andykarpov/karabas-pro/software/profi/net-tools/src/netman/readme.md

Исходники netman с поддержкой Karabas Pro доступны из оригинального репозитария nihirash:  https://github.com/nihirash/zx-net-tools/
либо из ветки karabas-pro форка https://github.com/andykarpov/zx-net-tools/

Для сборки используйте опции:

1. make karabaspro - для сборки версии под ZX UNO UART
2. make karabaspro-zifi - для сборки версии под ZIFI UART
