andykarpov/karabas-pro/software/profi/pq-dos/README.md

PQ-DOS boot

# Как создать загрузочную дискету с PQ-DOS

1) Записываем на SD карту образ pqdos1.fdi
2) По menu+F4 переходим в FDImage
3) Выбираем образ, записываем на дискету
4) Menu+F2 для переключения в режим PQ-DOS BIOS
5) вставляем дискету, загружаемся с нее

# Как создать загрузочный HDD из CF карты

## На PC (желательно под Linux)
1) создаем primary partition размером до 1 Гб типа FAT16
2) Устанавливаем флаг bootable на раздел
3) По желанию создаем extended partition и в нем N дополнительных разделов типа FAT16

## Грузимся с дискеты
4) Копируем с дискеты файлы TRDBOOT.BIN, QDOS.SYS, IO.DRV, CMD.COM, CONFIG.SYS и AUTOEXEC.BAT в корень диска C
Важно: файлы TRDBOOT.BIN, QDOS.SYS и IO.DRV должны быть нефрагментированы.
Можно утилитой sys это сделать, но она пока не проверяет файлы на фрагментированность
5) Создаем директорию DOS, копируем с дискеты все что касается DOS'а в эту диреторию
6) Создаем директорию DN, копируем все что касается DN в эту директорию
7) запускаем FIXBOOT C:
8) запускаем FIXMBR /PM

## Перезагружаемся без дискеты
9) профит! :)

ЗЫ: готовый образ 1ГБ CF-карточки можно скачать тут: 
https://drive.google.com/file/d/1a-WIUXuHLKoJI3obKjNGY0Axmqy46rGw/view?usp=sharing
