andykarpov/karabas-pro/software/profi/net-tools/release/README.md

Сетевые утилиты для Karabas PRO
===============================

На данный момент они работают только с SD-картой, и им критично расположение в каталоге Wifi(т.е. необходимо скопировать zinetman.$c, ziugophy.$c и player.bin в каталог wifi, находящийся в корне SD-карты).

У утилит нет зависимости от CP/M или PQ-DOS - используется загружаемый FatFS. 

Запускаются утилиты сразу из fatall'а.

Для настройки ESP и подключения к точке доступа используется netman - он проведет инициализацию чипа, получит список сетей и предложит вам выбрать нужную. 

Если там пролетит сообщение ERROR - это нормально. 

После настройки уже можно запускать ugophy и пользоваться им. Как только на экране появится приветственная страница - это означает, что вы уже онлайн(она грузится по сети).

Возможность скачивания файлов присутствует - пользуйтесь ей на здоровье.
