andykarpov/karabas-pro/DONATIONS.md

## Donations

### The Author

I will be happy to receive any amount of EUR/USD/UAH. 



### ROMain, FDImage tool, FlashTool, testROM by Doctor Max

Thanks to all bakers, with your help it was possible to release a nice new tool - **FDImage by Doctor Max!**, as well as **FlashTool** and the **ROMain**.

With the FDImage tool you're able to extract FDD images (FDI, PRO, TRD, SCL, TD0) to real floppy disks.

The FlashTool is a useful thing to help users upgrade their FPGA and ROM without touching a programmer.

The ROMain is a main ROM that you see on the screen after powering on the board. There are a few tests, including a test for extended karabas palette.

Feel free to send any amount of RUB/USD/EUR/etc to support **Doctor Max** - a developer of this nice tool:

QIWI: https://qiwi.com/n/DEXIUS

Webmonet WMID: 305965057957

Debt Card: 4817 7601 6316 7095

### Wi-Fi support and gopher browser by nihirash

It would be great to buy some coffee for **nihirash** - author of great tools to support internet on karabas-pro: https://nihirash.net.

Feel free to send any amount of USD/EUR/etc to support **nihirash**:



Thanks in advance to all bakers! :)

Your support matters!
