andykarpov/karabas-pro/docs/photos/karabas-pro-revB-bot.png

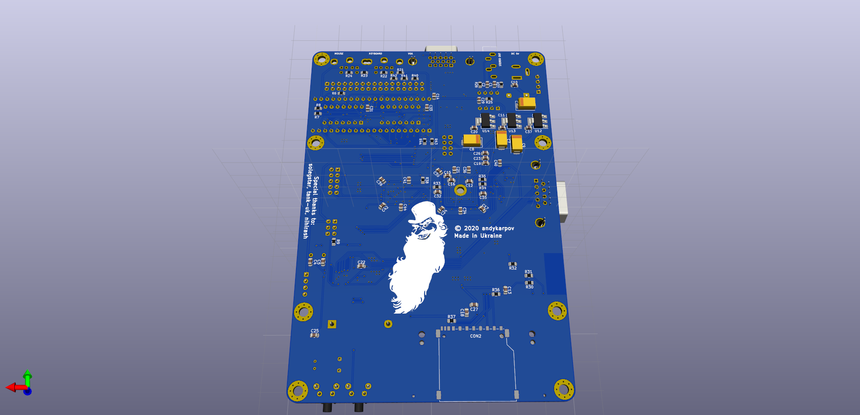
docs/photos/karabas-pro-revB-bot.png
