andykarpov/karabas-pro/docs/photos/karabas-pro-revB-top.png

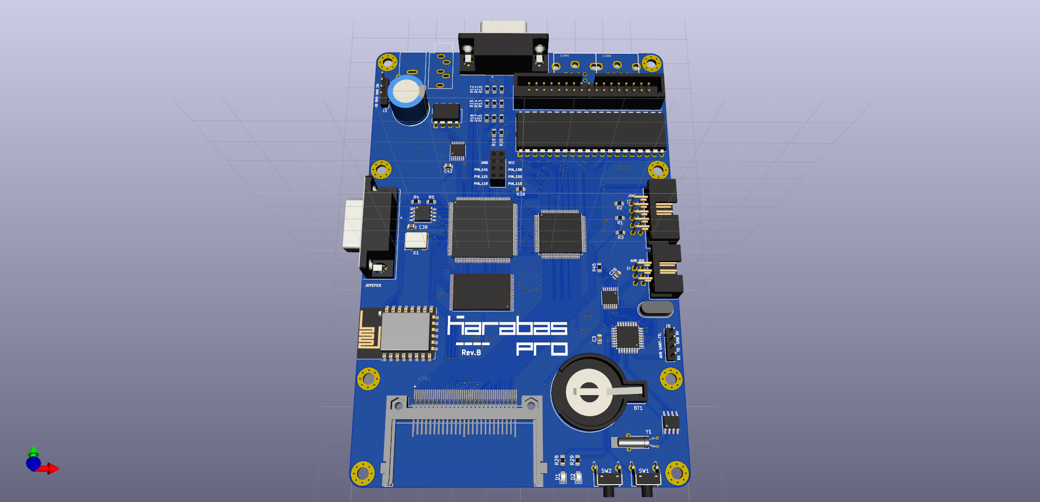
docs/photos/karabas-pro-revB-top.png
