andykarpov/karabas-pro/docs/photos/karabas-pro-revC-back.png

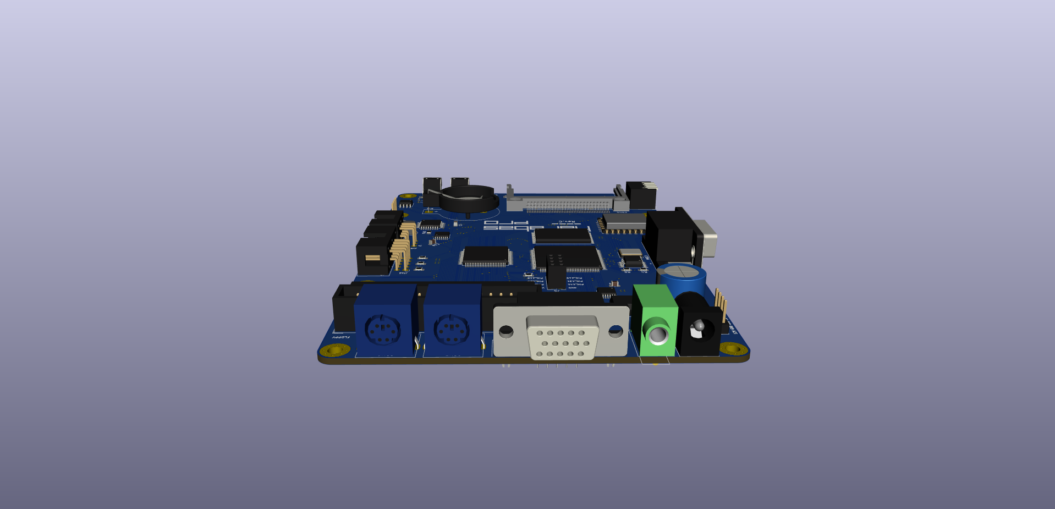
docs/photos/karabas-pro-revC-back.png
