andykarpov/karabas-pro/docs/photos/karabas-pro-revD-bot.png

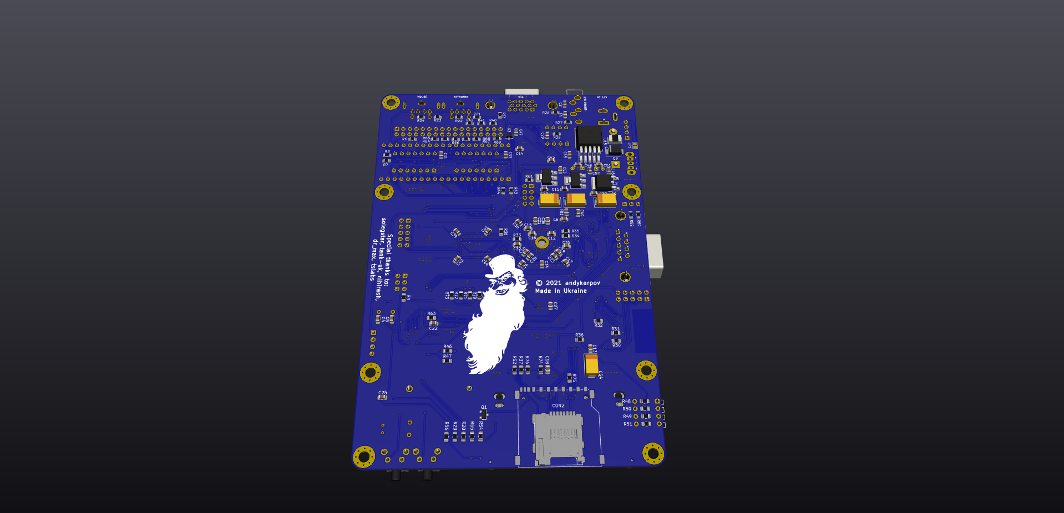
docs/photos/karabas-pro-revD-bot.png
