andykarpov/karabas-pro/docs/photos/karabas-pro-tapeMod_revA-bottom-3d.png

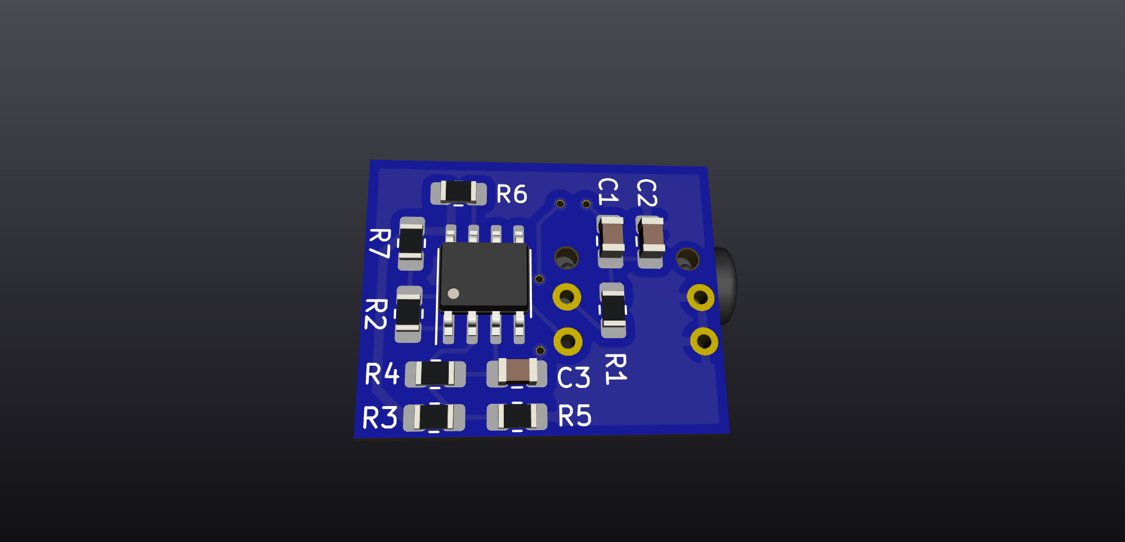
docs/photos/karabas-pro-tapeMod_revA-bottom-3d.png
