andykarpov/karabas-pro/docs/photos/karabas-pro-tapeMod_revA-top-3d.png

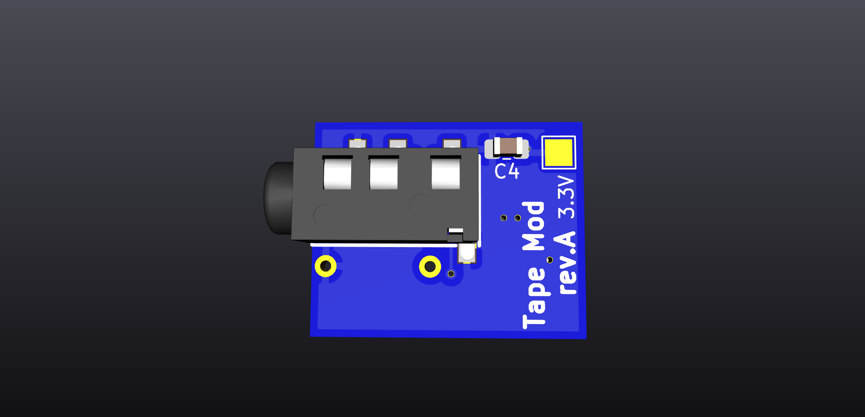
docs/photos/karabas-pro-tapeMod_revA-top-3d.png
