andykarpov/karabas-pro/cases/revC/Karabas_case_FDD_bottom_v1.stl

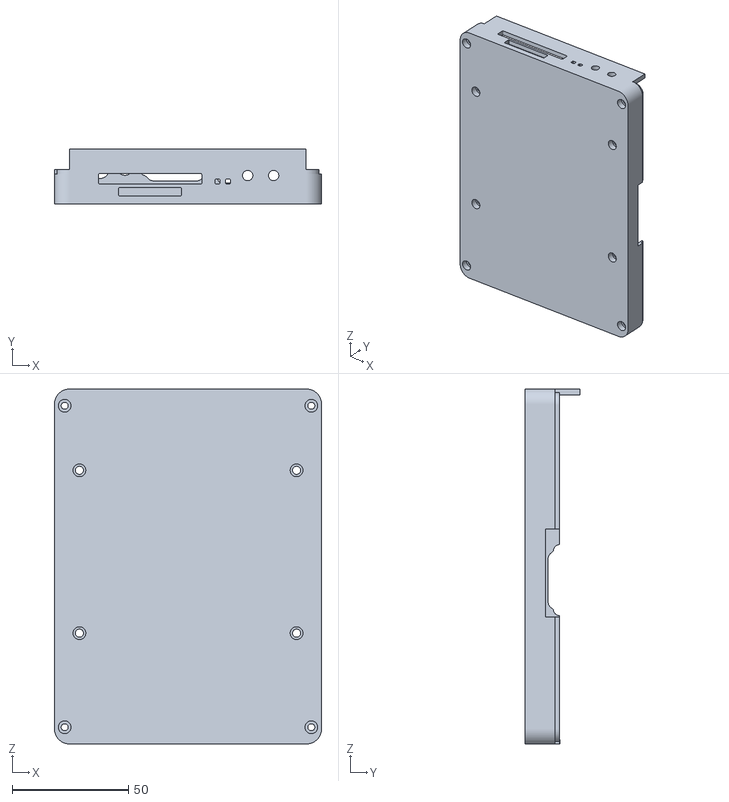
[picture p26: CAD file, 2021-06-01]
cases/revC/Karabas_case_FDD_bottom_v1.stl
115.0 x 23.5 x 152.8
