andykarpov/karabas-pro/cases/revC/Karabas_case_FDD_Logo_top_v1.stl

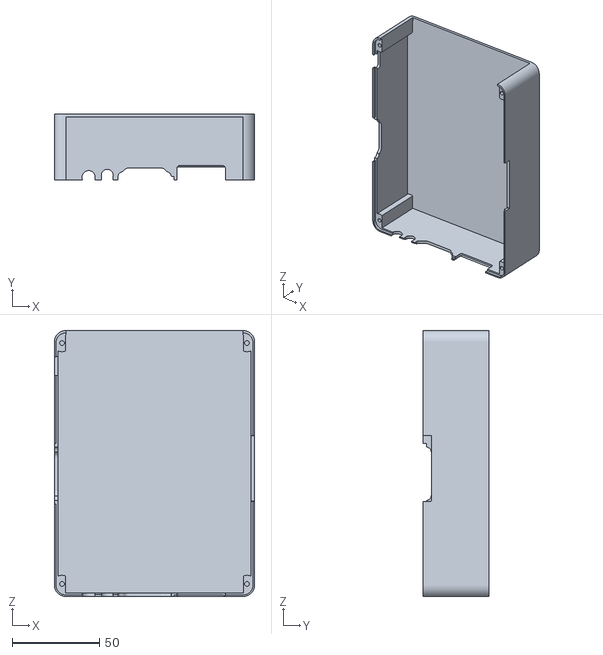
[picture p27: CAD file, 2021-06-01]
cases/revC/Karabas_case_FDD_Logo_top_v1.stl
115.0 x 38.0 x 152.8
