andykarpov/karabas-pro/cases/revDS/KarabasDS_FDD_Logo_case_top_v1.0.stl

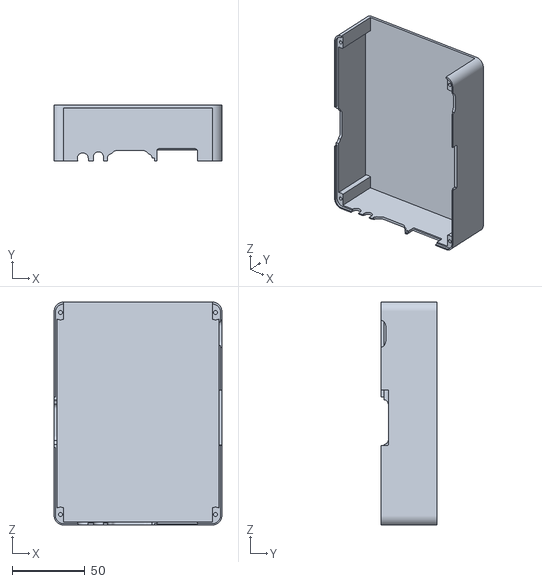
[picture p28: CAD file, 2021-06-01]
cases/revDS/KarabasDS_FDD_Logo_case_top_v1.0.stl
115.0 x 38.1 x 152.8
