andykarpov/karabas-pro/cases/revC/Karabas_case_top_v1.2.stl

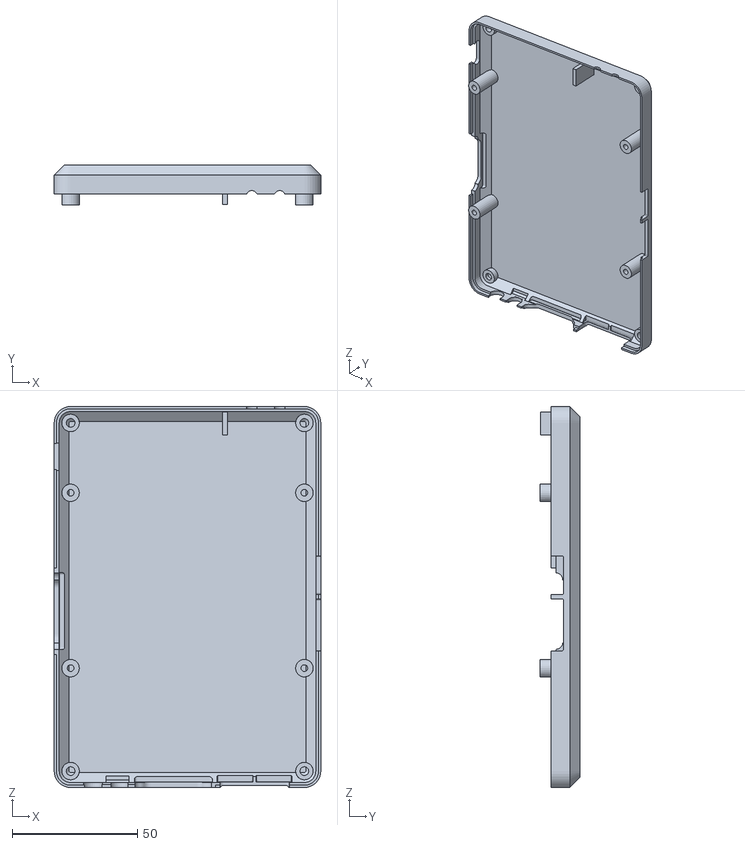
[picture p29: CAD file, 2021-06-01]
cases/revC/Karabas_case_top_v1.2.stl
106.6 x 15.8 x 152.3
