andykarpov/karabas-pro/cases/revC/Karabas_case_bottom_v1.2.stl

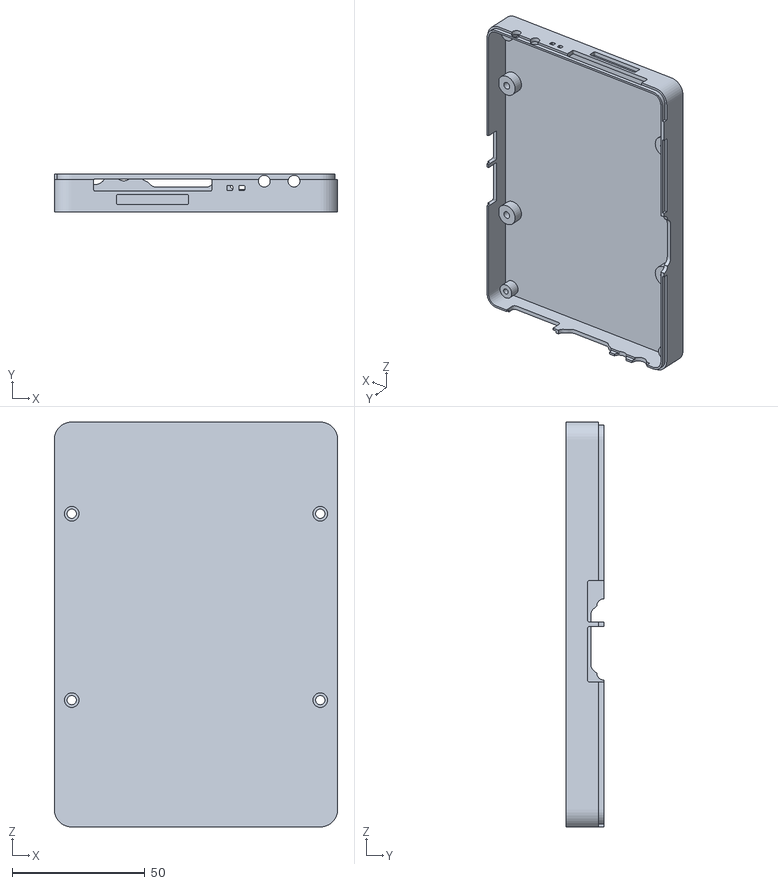
[picture p30: CAD file, 2021-06-01]
cases/revC/Karabas_case_bottom_v1.2.stl
106.6 x 14.4 x 152.3
