andykarpov/karabas-pro/(list of files, cad)

Other CAD files:
cases/revDS/KarabasDS_FDD_case_bottom_v1.N.stl
cases/revDS/KarabasDS_FDD_case_bottom_v1.0.stl
cases/revC/Karabas_case_FDD_top_v1.stl
cases/revC/Karabas_case_FDD_bottom_Support_v1.stl
