andykarpov/karabas-pro/docs/How to write FDI-image on real zx_spectrum_ru.docx

Методика подходит для записи FDI-образов на реальном ZX-Spectrum, оборудованным одним из таких устройств как - Z-Controller, NeoGS или NemoIDE. На примере компьютера Karabas-Pro.

1. Скачать утилиту Wild Disk Copier со всеми плагинами по ссылке на SD-CARD.

https://github.com/andykarpov/karabas-pro/tree/master/software/profi/tools

2. В Сервисном меню Профи выбрать пункт Fatall 0.26.

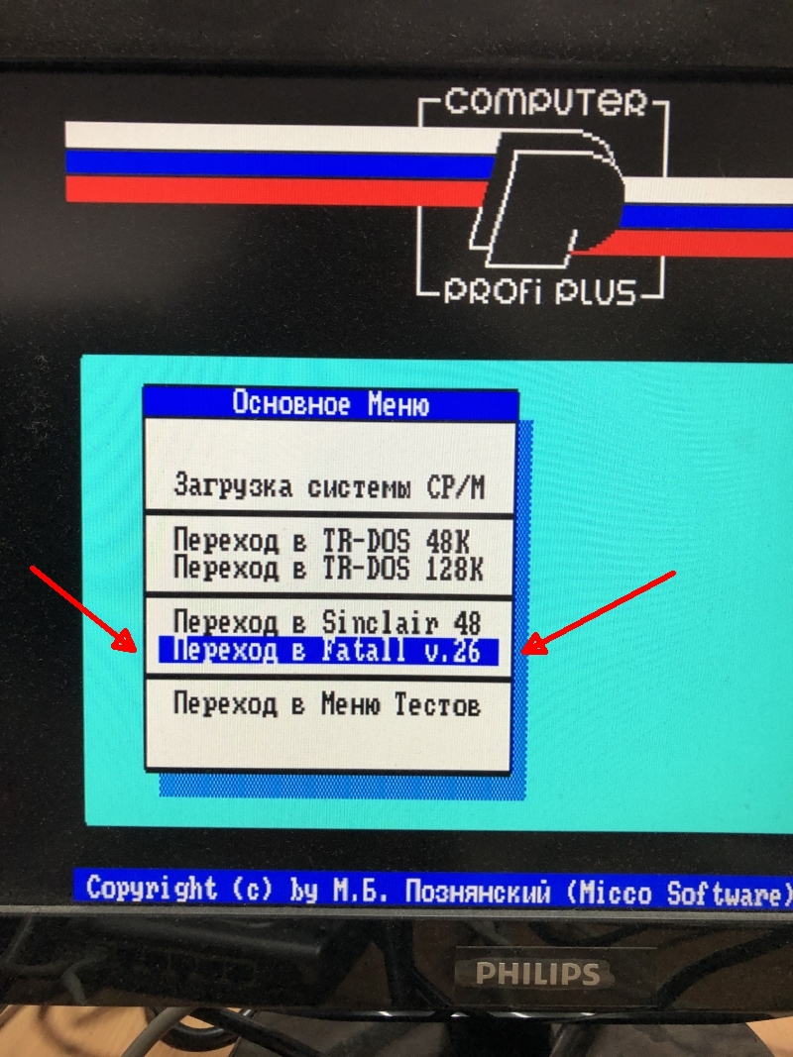
[picture p40: figure]

3. Запустить файл WDC1_26.$C, нажав на нем клавишу Enter.

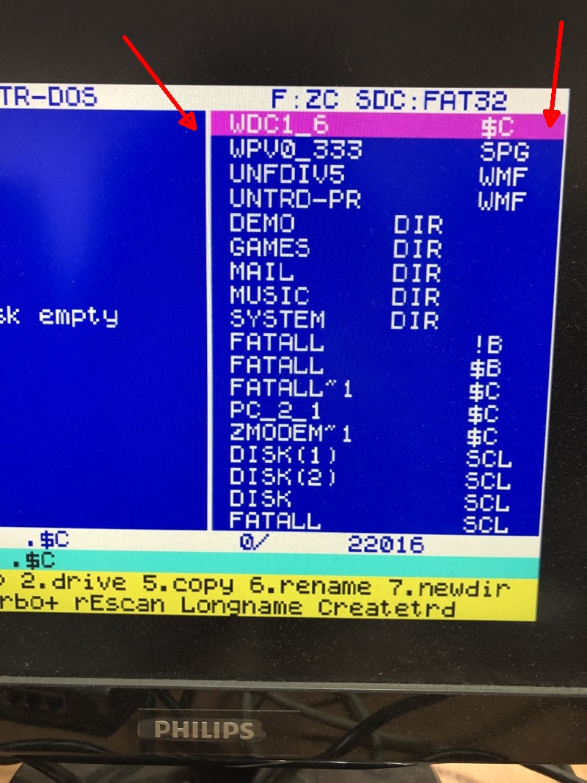
[picture p41: figure]

4. В появившемся меню «Select Driver:» нажать клавишу «3», выбрав драйвер с поддержкой SD-CARD по стандарту ZC (или устройства, которое есть в наличии).

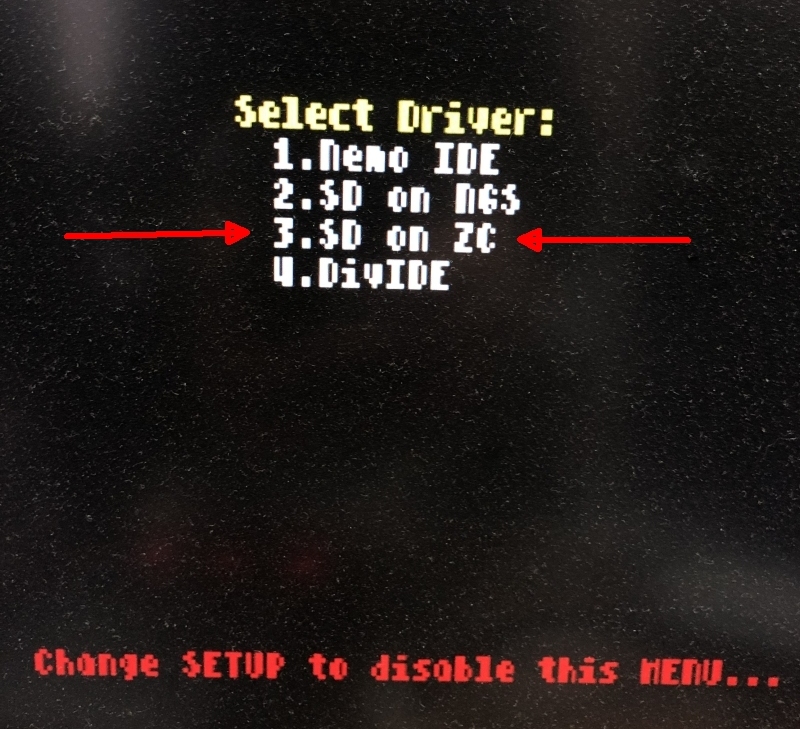
[picture p42: figure]

5. Выделить файл UNFDIV5.WMF и нажать на нем Enter.

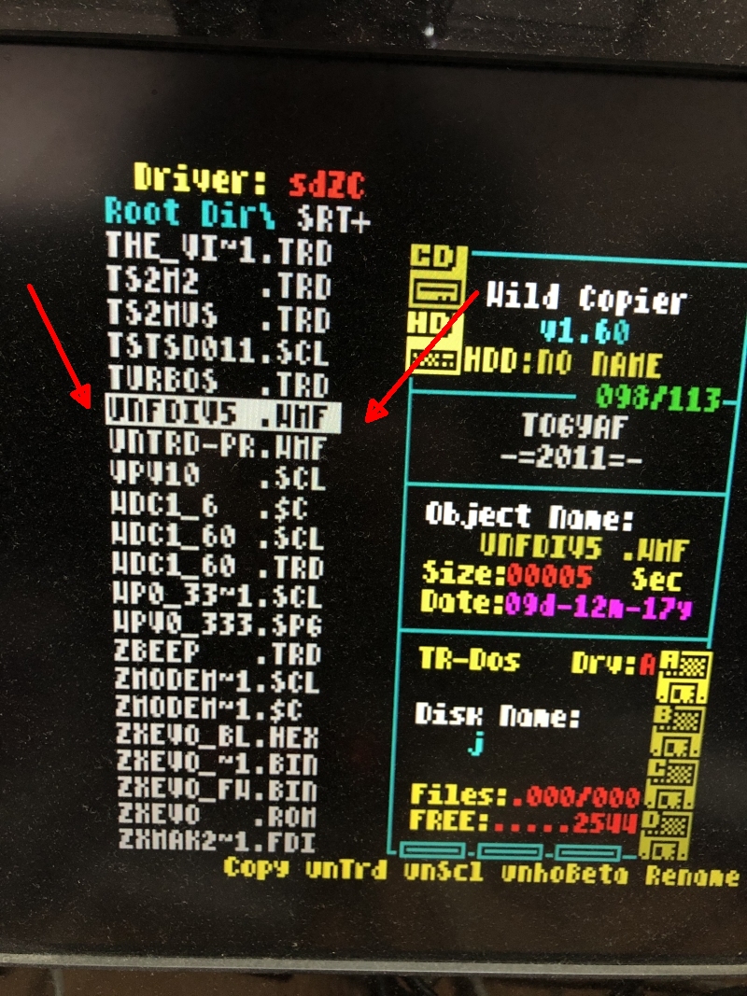
[picture p43: figure]

6. Клавишами 1-4 выбрать дисковод, на который будет записываться образ.
7. Выделить файл с образом *.FDI и нажать клавишу «F».

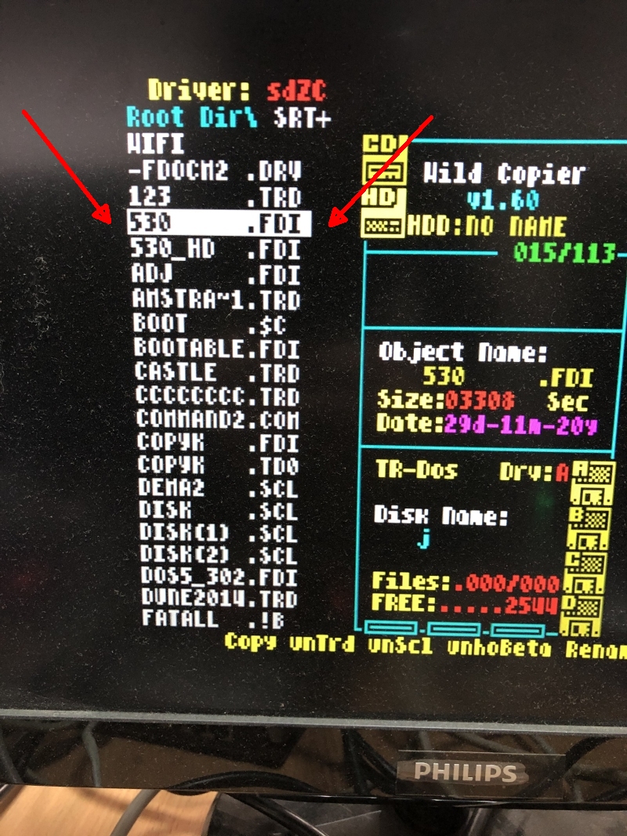
[picture p44: figure]

8. На запрос «Formatting Y/N» нажать клавишу «Y».

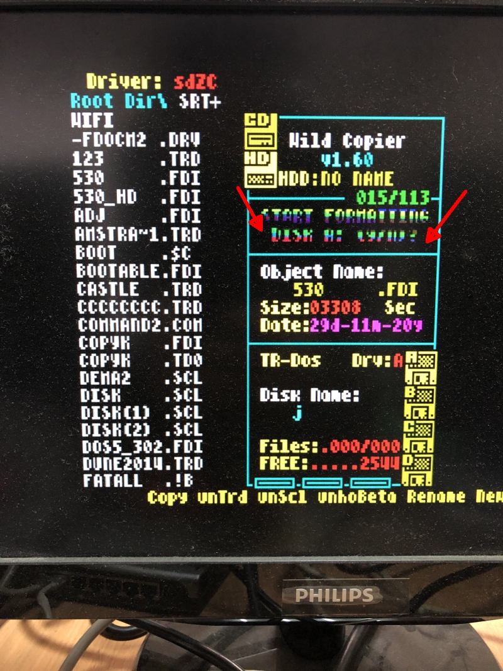
[picture p45: figure]

9. Дождаться записи образа на дискету.
