andykarpov/karabas-pro/ERRATA-REVB.md

# ERRATA rev.B

1) Missing 10k pull-up on the /AVR_CS line. Without that pull-up you'll be unable to flash AVR properly on-board.
2) Missing 10k pupp-ups on the BTN1, BTN1 lines.
