andykarpov/karabas-pro/(threads)

Thread 3 (2020-07-29):

PCB: добавить возможность установки ВГ93

andykarpov, 2020-07-29:
1) добавить преобразователь 12В-5В
2) добавить диоды
3) завести 12в на разъем для дисковода

andykarpov, 2020-08-13:
Преобразователь решил не делать, завел 12В с разъема через диоды

Closed 2020-08-13.

Thread 6 (2020-07-31):

PCB: подтяжки

andykarpov, 2020-07-31:
Добавить подтяжки на:
- /AVR_CS, иначе мегу можно запороть, прошивая прямо на плате
- BTN1, BTN2 - у меги эти два входа - чисто аналоговые, там цифповой части нет, соотв и возможности включить встроенные pull-up

andykarpov, 2020-08-13:
Done

Closed 2020-08-13.

Thread 7 (2020-08-14):

Add +5V supply voltage to pin 9 of the VGA connector through footprint 0805.

solegstar, 2020-08-14:
Add + 5V supply voltage to pin 9 of the VGA connector through footprint 0805.

Several purposes are possible:
1. For normal use of the VGA connector - do not solder anything.
2. When using a VGA-HDMI converter, or if you need power at the VGA connector, solder a 0 Ohm resistor.
3. When using the VGA-SCART cable, you can solder a 150-200 ohm resistor and use it to switch the TV to the RGB mode.

andykarpov, 2020-08-14:
Done

Closed 2020-08-14.

Thread 10 (2020-09-29):

AtMega&FPGA: Управление турборежимом

solegstar, 2020-09-29:
Добавить горячую клавишу для управления турборежимом. предложение - win menu + F11. Бит с фиксацией состояния и возможно с запоминанием состояния во внутренней памяти меги.

andykarpov, 2020-10-06:
готово в ветке turbo

Closed 2020-10-06.

Thread 13 (2020-09-29):

FPGA&CPLD:Турборежим

solegstar, 2020-09-29:
Добавить режим повышенного быстродействия Профи.

andykarpov, 2020-09-29:
Тут надо думать, как подружить турбо-режим, память и самое главное - проброс zx bus в CPLD

andykarpov, 2020-10-06:
У нас шина для проброса сигналов ZX BUS имеет разрядность 8 бит.
И пробрасывается из FPGA в CPLD она за 4 такта клока 28 МГц.
Соответственно, в турбо режиме нужно будет умножить тактовую проброса на 2.
То есть, вероятно, весь дизайн перевести на 56 МГц :)

Closed 2020-10-13.

Thread 14 (2020-09-29):

FPGA: UART

andykarpov, 2020-09-29:
Реализовать порты по Кондратьеву на стороне FPGA, сделать вывод RX,TX,CTS,RTS на свободные пины FPGA.

andykarpov, 2021-08-09:
Сейчас для циклона 10к сделан второй UART на uBUS по стандарту ZX-UNO.

Closed 2021-08-09.

Thread 15 (2020-09-30):

FPGA: Serial Mouse

andykarpov, 2020-09-30:
Сделать эмуляцию протокола **Serial мыши** по стандартным портам профика **#F3, #D3, #B3** и тп (ВВ51, ВИ53) в виде отдельного модуля, в который приходят DX,DY,состояние кнопок из AVR (такие же, как используются для кемпстон-мыши).

Материалы для изучения:

- https://www.systutorials.com/docs/linux/man/4-mouse/
- http://www.cpcwiki.eu/index.php/Serial_RS232_Mouse
- https://everything2.com/title/Mouse+protocol
- https://raspberrypi.stackexchange.com/questions/81465/usb-to-serial-rs232-mouse-converter
- http://ww1.microchip.com/downloads/en/appnotes/00519c.pdf

Closed 2020-10-04.

Thread 33 (2020-10-27):

Попробовать UsbHost внутри FPGA

andykarpov, 2020-10-27:
Разобраться в проекте https://github.com/andykarpov/UsbHost/, https://marsohod.org/projects/proekty-dlya-platy-marsokhod3/404-two-usbhost-ports-keyb-mouse, https://marsohod.org/projects/proekty-dlya-platy-marsokhod3/399-usb-host-ctrl,
попробовать реализовать вместо PS/2 + AVR или рядом, для начала - на debug header'е.

Closed 2021-08-09.

Thread 42 (2021-02-18):

AVR: Зависания клавиатуры

andykarpov, 2021-02-18:
Отдебажить и выявить место, где именно в основном цикле происходят залипания логики

andykarpov, 2021-02-20:
в последней прошивке убрал опрос мыши, заменил библиотеку Wire на SWire с неблокирующим ожиданием. вроде проблема ушла.

Closed 2021-02-20.

Thread 43 (2021-03-03):

Добавить моно режим AY

nihirash, 2021-03-03:
Помимо ABC/ACB ввести еще режим Mono ради страдальцев вроде меня :-)

andykarpov, 2021-03-03:
Хех, беда в том, что я уже пробовал его добавить :)))

Переделок возникло - просто масса:

1) 64-байтную посылку между AVR и FPGA нужно добавить еще один байт для передачи нового состояния (хотя там у @solegstar тоже была хотелка для ремапа буквы дисковода по хоткею - так что придется заводить :)

2) чтобы смикшировать программно 2 16-битных сигнала (сложить их, фактически) нужно делать запас на 1 бит от переполнения, то есть результирующий вектор получится 17-битным. и что потом делать - пока не придумал, наверно отрезать младший бит :)

3) При добавлении новой комбинаторной логики в FPGA проект перестает собираться в работоспособном состоянии. Тут, конечно, связано в роутинге внутри FPGA и в отсутствии constraint'ов по клокам, распространению сигналов и тп :) Я даже отдельную ветку завел с игрищами в этом направлении.

В общем попробую в отдельной ветке, вдруг получится :)

andykarpov, 2021-03-08:
Моно режим добавлен в ветке timequest_constraints.
Переключается по Menu+F7 (по кругу - ABC, ACB, MONO).

andykarpov, 2021-03-08:
TO BE TESTED :)

Thread 48 (2021-04-03):

Сделать поддержку геймпада от Sega

andykarpov, 2021-04-03:
Решили делать на стороне FPGA:
0) нужны доработки платы: подать питание +5В на DB9 разъем, а также сигнал select со светодида LED2 (ACT)
1) по хоткею Menu+J будет переключаться режим опроса - механический / sega и отображаться в OSD
2) на стороне меги механический джой будет отдавать 2 старших бита как 0, а sega джой - доп кнопки A, Menu
3) на стороне FPGA будет расширен прием всех 8 бит для порта джоя

Closed 2021-04-05.

Thread 54 (2021-06-02):

Karabas-pro BIOS

andykarpov, 2021-06-02:
Подумать над ТЗ, что должно входить в концепцию BIOS'а для karabas-pro, разработать прототипы экранов и ТЗ для MVP версии. Продумать, как ПЗУ с BIOS будет стартовать, откуда и как переключаться на выбранную прошивку и конфиг и тп.

nihirash, 2021-06-02:
Желательно описать еще как сохранять настройки, чтобы после выключения не начинать с чистого листа 😸

Часы, как я понимаю, не то, чтобы свободны

andykarpov, 2021-08-09:
Пока потребность BIOS'а частично закрыли новым OSD.
Как будут сформированы новые идеи - переоткроем.

Closed 2021-08-09.

Thread 55 (2021-06-21):

Не работает PS/2 клавиатура Perixx PERIBOARD-505

zapolnov, 2021-06-21:
Отладка по UART показала, что клавиатура при подключении посылает постоянно сканкод 0xAA, других сканкодов не посылает.

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

С Эволюшеном и ZXDOS+ клавиатура работает.

По результатам обсуждения в чате Карабаса есть мнение, что клавиатура посылает 0xAA с неправильной четностью, ожидая от компьютера ответ 0xFE, чтобы убедиться, что компьютер включен (https://forum.arduino.cc/t/ps2keyboard-library-teensy-and-usb-keyboard-with-ps2-adapter/57549/7).

andykarpov, 2021-06-21:
В проекте используется вот такая простенькая либа для PS/2 клавы: https://github.com/techpaul/PS2KeyRaw
Контроль четности в ней есть, и по-идее на неправильную четность должно ответить как раз 0xFE.
Что еще может не нравиться клавиатуре - сложно сказать.

Попробую переписать код на базе PS2KeyAdvanced от того же автора, код занимает больше места, но и руки больше развязны будут :) С клавой можно будет общаться, посылать состояния светодиодов и другие команды.
Возможно, в ней этого бага нет. Нужно будет поиграться :)

andykarpov, 2021-07-15:
В общем, в ветке avr-ps2keyadvanced закоммичена новая реализация: https://github.com/andykarpov/karabas-pro/tree/avr-ps2keyadvanced/firmware/releases/profi/avr , просьба затестить.
С вероятностью 99% все заработает :)

Для обновления прошивки AVR потребуется программатор, usbasp или аналогичный, с переходником под 6-пиновый разъем. Шить как обычно: `avrdude -c usbasp -p m328p -U flash:w:karabas_pro_revD.hex -U lfuse:w:0xFF:m -U hfuse:w:0xDE:m` (где суффик имени файла прошивки - в зависимости от ревизии платы: revA - для плат ревизии А, revD - для плат ревизий D или DS, без суффикса - для плат ревизии B, C.

Closed 2021-08-09.

Thread 57 (2021-08-03):

"Дребезг" клавиатуры.

Deboshnow, 2021-08-03:
Выявил баг с клавиатурой..  Когда шарюсь в Real Commander-e 1.96  иногда вместо курсора вверх или вниз(Caps Shift + 7 или Caps Shift + 6) Атмега выдаёт 6 или 7, а на этих цифрах в Реал командере сидят команды 6 -переименовать файл, 7- переименовать диск. Возможно и на других клавишах баг проявляется. Как будто дребезг контактов клавы)) Но никакого дребезга-то нет.  Клава на Атмегу выдаёт сканкод, а уже Атмега на Альтеру шлет сочетание клавиш? Так ведь?    А происходит этот баг не часто, но в самый не подходящий момент.  Этот баг был замечен еще на ревизии "С". Тогда я не придал этому особого значения. Радовался уже тому, что клавиатура залипать перестала =)  Баг не зависит от режима клавиатуры XT или Spectrum. Во встроенном тесте клавиатуры визуально не выявляется.

Deboshnow, 2021-08-05:
На Профике с Real Commander-ом проблем никогда небыло. В том числе и на плёночной клавиатуре с курсорными клавишами. По хорошему надо-бы плёнку разобрать и посмотреть как это реализовано. Думаю, что скорее всего так и реализовано. Сначала зажимается Caps Shift (или Symbol Shift для знаков препинания), а затем уже клавиша, соответствующая курсору. И отпускается в обратном порядке.

Deboshnow, 2021-08-05:
Нашел статью из журнала Радио Любитель №03 1994: http://sblive.narod.ru/ZX-Spectrum/MembraneKeyboard/rl19940313.gif     в которой написано: " При этом во избежание сбоев необходимо предусмотреть более раннее замыкание контактов, соответствующих клавишам "CS" и "SS"."

Closed 2021-08-09.

Thread 61 (2021-09-02):

Сделать инициализацию SD карты через OSD

andykarpov, 2021-09-02:
По мотивам http://www.rjhcoding.com/avrc-sd-interface-1.php

Реализовать:

1) конечный автомат на стороне FPGA, который:
- отключит SD карту от z-controller'а
- пошлет всю необходимую последовательность команд в SD-шку по внешнему сигналу запуска
- вернет SD-карту под управление Z-controller'а

2) на стороне AVR дореализовать в OSD интерфейс меню запуска инициализации SD-карты

Thread 63 (2021-09-08):

Режим классики - 312 строк

andykarpov, 2021-09-08:
Реализовать возможность переключения видеорежима спектрума 320 / 312 строк.
Для этого:
1) на стороне AVR завести новый настраиваемый параметр "Mode" с режимами "Pentagon" (по-умолчанию) и "Spectrum"
2) сохранять и восстанавливать этот параметр в/из EEPROM
3) передавать этот новый параметр на сторону FPGA
4) в видеоконтроллер завести входной сигнал "video_mode: std_logic"
5) сделать логику переключения количества строк в кадре, также переделать положение INT
6) опционально: сделать эмуляцию медленной памяти классического 128-го спектрума

Closed 2021-09-16.

Thread 67 (2021-10-29):

OSD popup: нажатие хоткея в момент отображения bootscreen'а

andykarpov, 2021-10-29:
Если в момент отображения бут-скрина нажать какой-либо хоткей, например Menu+F11, на экране отображается мусор.
Что сделать: очищать память osd popup перед отображением.

Closed 2021-10-31.

Thread 68 (2021-10-29):

OSD overlay: отображение часов, когда нет микросхемы часов или время не выставлено

andykarpov, 2021-10-29:
Когда нет микросхемы часов или батарейки, время в регистрах часов может быть невалидным, из-за чего рвется отображение в OSD.
Что сделать: ограничить при выводе разряды часов, минут, секунд до 2х.

Closed 2021-10-31.

Thread 70 (2021-10-29):

Документация разработчика

andykarpov, 2021-10-29:
Описать для начала все порты, присутствующие в железке.

andykarpov, 2021-10-29:
Надо обязательно по cs‘ам пройтись и все сигналы как есть описывать, ша, iorq, итд.
Чтоб уже точно вопросов не было (c) @solegstar ;)

andykarpov, 2023-07-07:
Добавить в доку порты ZIFI

andykarpov, 2023-07-19:
Добавить в доку порты DivMMC

andykarpov, 2023-09-02:
Добавить в доку порты NemoIDE

Thread 79 (2022-10-15):

Новая фича - тип джойстика

andykarpov, 2022-10-15:
Сделать возможность выбирать интерфейс джойстика для эмуляции:
- Kempston
- Sinclair 1
- Sinclair 2
- Cursor joystick
- QAOPNM и возможно доп кнопки сега-джоя на ZXCV или куда-то там

Для этого:
1) в OSD добавить новый пункт для настройки типа джойстика
2) данную настройку передавать на сторону FPGA по SPI (тут надо подумать, может быть передавать только для того, чтобы отключить порт kempston джойстика, когда выбран не он)
3) добавить в логику опроса клавиатуры маппинг на соотв кнопки (для типов Sinclair 1,2,cursor,QAOP...) в зависимости от выбора

andykarpov, 2023-07-07:
Готово в релизе v23070719

Closed 2023-07-07.

Thread 88 (2023-07-19):

Поддержка кастомных мапперов для SEGA-джойстиков на 6/12 кнопок

andykarpov, 2023-07-19:
Идея: на стороне AVR сделать поддержку N кастомных раскладок SEGA-джойстика для задания клавиатурных соответствий кнопкам

Для этого:
1) в OSD меню `Joy Mode` ввести еще 3 опции: `Custom 1, Custom 2, Custom 3`
2) в OSD меню сделать переход в `редактор кастомных раскладок`
3) реализовать редактор кастомных раскладок
3.1) в редакторе будет` выбор`, какую раскладку редактировать
3.2) на странице раскладки будет `12 строк`, соответствующие каждой кнопке (`Up, Down, Left, Right, A,B,X,Y, Start, Menu, L, R`)
3.3) с помощью `курсора` можно выбрать редактируемую кнопку джойстика, с помощью `Enter` провалиться в задание кнопки клавиатуры, `ESC` - режим выхода из режима редактирования позиции
3.4) сохранение будет вестись в `EEPROM` меги автоматически, при выходе из режима редактирования
4) сделать `маппинг` новых опций Custom 1, Custom 2, Custom 3 на кнопки клавиатуры на стороне меги

andykarpov, 2023-09-02:
к сожалению, уже не для этого камня. Для следующей ревизии карабаса на rp2040 ;)

Closed 2023-09-02.

Thread 90 (2023-07-19):

Реализовать поддержку RTC по стандарту Gluk

andykarpov, 2023-07-19:
Подумать, что делать с пересекающимися портами и реализовать.

Caasper911, 2023-07-19:
Глюк по 'стандарту' включается на доступ одним из битов порта 1FFD, если я не ошибаюсь

andykarpov, 2025-02-10:
Статья: "[CMOS для всех](http://zxdn.narod.ru/hardware/op31cmos.htm)" из электронной газеты Optron #31.

Использование портов, по которым можно было обращаться к часам, стало неким стандартом для ZX-Spectrum и было поддержано в многих программах:
#DFF7 - задаёт номер регистра, с которым мы хотим работать;
#BFF7 - порт данных, через него передаются данные в микросхему/из неё;
#EFF7 - бит 7 этого порта управляет доступом к микросхеме (0 - доступа нет, 1 - доступ есть).

Thread 101 (2023-09-02):

Залипание Alt при переключении ромбанков через Ctrl+Alt+Fx

andykarpov, 2023-09-02:
достаточно ctrl и alt жмакать, судя по встроенному тесту клавы alt залипает пока его ещё раз не нажмёшь.

andykarpov, 2023-09-02:
Теоретически должно быть поправлено в сборке AVR 23090220

Closed 2023-09-02.

Thread 96 (2023-09-02):

Logitech мышь - в последних прошивках работают не все мыши

andykarpov, 2023-09-02:
Начиная с версии  avr21080721 (после мега-рефакторинга) перестали работать некоторые мыши Logitech.
Пока нет идей, что не так, код плюс-минус идентичный.

andykarpov, 2023-09-02:
Теоретически должно быть поправлено в сборке AVR 23090220
- добавлено больше попыток инициализации мыши при старте
- конфигурация ног для PS/2 мыши происходит как можно раньше при старте

Closed 2023-09-02.

Thread 98 (2023-09-02):

Сломалась функция swap'а буквы A-B дисковода

andykarpov, 2023-09-02:

andykarpov, 2023-09-02:
Олег Стариченко, [01.09.2023 12:54]
kasper внес сигнал трдос в отключение турбы, якобы для борьбы с багом флопа. я ему об этом писал, но видимо не поправил

Олег Стариченко, [01.09.2023 12:54]
но сигнал трдос - он также активирует 0 банку пзу

Олег Стариченко, [01.09.2023 13:03]
смена дисководов поломалась по причине ввода двух стандартов винта немо и профи. вообще, в нормальном виде bios не должен виснуть. скорее всего это связано с твоей картой

Олег Стариченко, [01.09.2023 13:04]
достань карту и посмотри, она должна также появится, эта надпись.

Олег Стариченко, [01.09.2023 13:04]
может вадим что-то исправил

Closed 2023-09-06.

Thread 99 (2023-09-02):

Баг с отключением Турбо для TR-DOS

andykarpov, 2023-09-02:
Нужно вернуть назад, PQ-DOS от этого чуток плющит и он показывает всегда 3.0 МГц в биосе

andykarpov, 2023-09-02:
Олег Стариченко, [01.09.2023 12:54]
kasper внес сигнал трдос в отключение турбы, якобы для борьбы с багом флопа. я ему об этом писал, но видимо не поправил

но сигнал трдос - он также активирует 0 банку пзу

Closed 2023-09-06.

Thread 105 (2023-09-11):

DskChg сигнал

andykarpov, 2023-09-11:
Запрос от Вадима:

На ПЦ, начиная с дисководов 5.25 1.2M появился сигнал Disk Chg. Он показывает, что дискету меняли.

Типа вот мы взяли и прочитали сектор или записали. Потом мотор выключился, мы взяли и открыли дверцу и закрыли (этого достаточно для смены триггера). И потом при обращении к дискете этот сигнал нам покажет, что была смена

Он совмещен с сигналом Ready'. 34й вывод от дисковода. При включении мотора (я по памяти пишу, ещё в 90х исследовал этот сигнал и логику его работы) сигнал стоит примерно 1с в состоянии лог 1, и потом переходит в сост 0. (типа дисковод готов). Кстати, на +3 этот сигнал используется, без него ничего грузиться не будет. Так вот. Как получить состояние disk chg?

Пока DskChg/Ready находится в сост лог1., если была смена дискеты, то идут быстрые переключения в 0, их несколько штук проскакивает, как иголка. И потом уже сигнал переходит в 0 надолго, говоря нам о том, что Disk Ready

И вот там бы схему сепарации сделать и через порт какой-нибудь читать нам и сигнал ready и dsk chg

Для режима спектрума это будет незаметно, а я в DOSе получу очень хорошую поддержку.

Нужно исследование, как мы можем выделить такой сигнал из имеющегося на стороне FPGA. ну а за портом, откуда его вычитывать - не заржавеет :) И сразу нужно понять, как это потом релизовать железно для оригинального профи, например

Caasper911, 2023-09-11:
А если дисководов несколько, как определить в каком дискета поменялась?

Thread 112 (2025-07-31):

PLEASE HELP KARABAS PRO REV E FOR FLOPPY

nicolaebizi, 2025-07-31:
Greetings
I finished Krabas pro REV E and I was waiting for an integrated for floppy, because I put the net with 2 pieces of rescissed that killed the supply voltage. In the meantime I unsoldered 74ls06 and 74ls38, confirming that 74ls06 has a defective gate. I replaced the integrated and to be sure that no other damage occurred I also replaced EPM3128ATC100. When wd1793 arrived I installed it and found that it did not work.
In the meantime I also made EVGENIY UGRUMOV's emulator, confirming the following:
With a physical unit I managed to write a trd image to the floppy disk.
I can't write anything with Gotec, I think R 64-69 of 330 ohm is influencing something (I soldered them)
The floppy disk was created without error and in the menu =MENU+F2= READS IT BUT DOESN'T EXECUTE IT ....
CAN SOMEONE HELP ME?

andykarpov, 2025-08-13:
Also please check the U7 (a level shifter), it contains a signal FDC_STEP. Please check if it is working and converting from LFDC_STEP (3.3v) to FDC_STEP(5v) levels. If not - try to replace that IC.
Some TXB0104 from aliexpress has a broken channels, so maybe that could be a reason the floppy is stuck in the track 0.

Caasper911, 2025-08-13:
Salut Nikolae, dacă ești în Oradea te pot ajuta să testezi Karabas Pro.

Closed 2025-08-13.
