andykarpov/karabas-pro/docs/karabas-pro-revDS.pdf

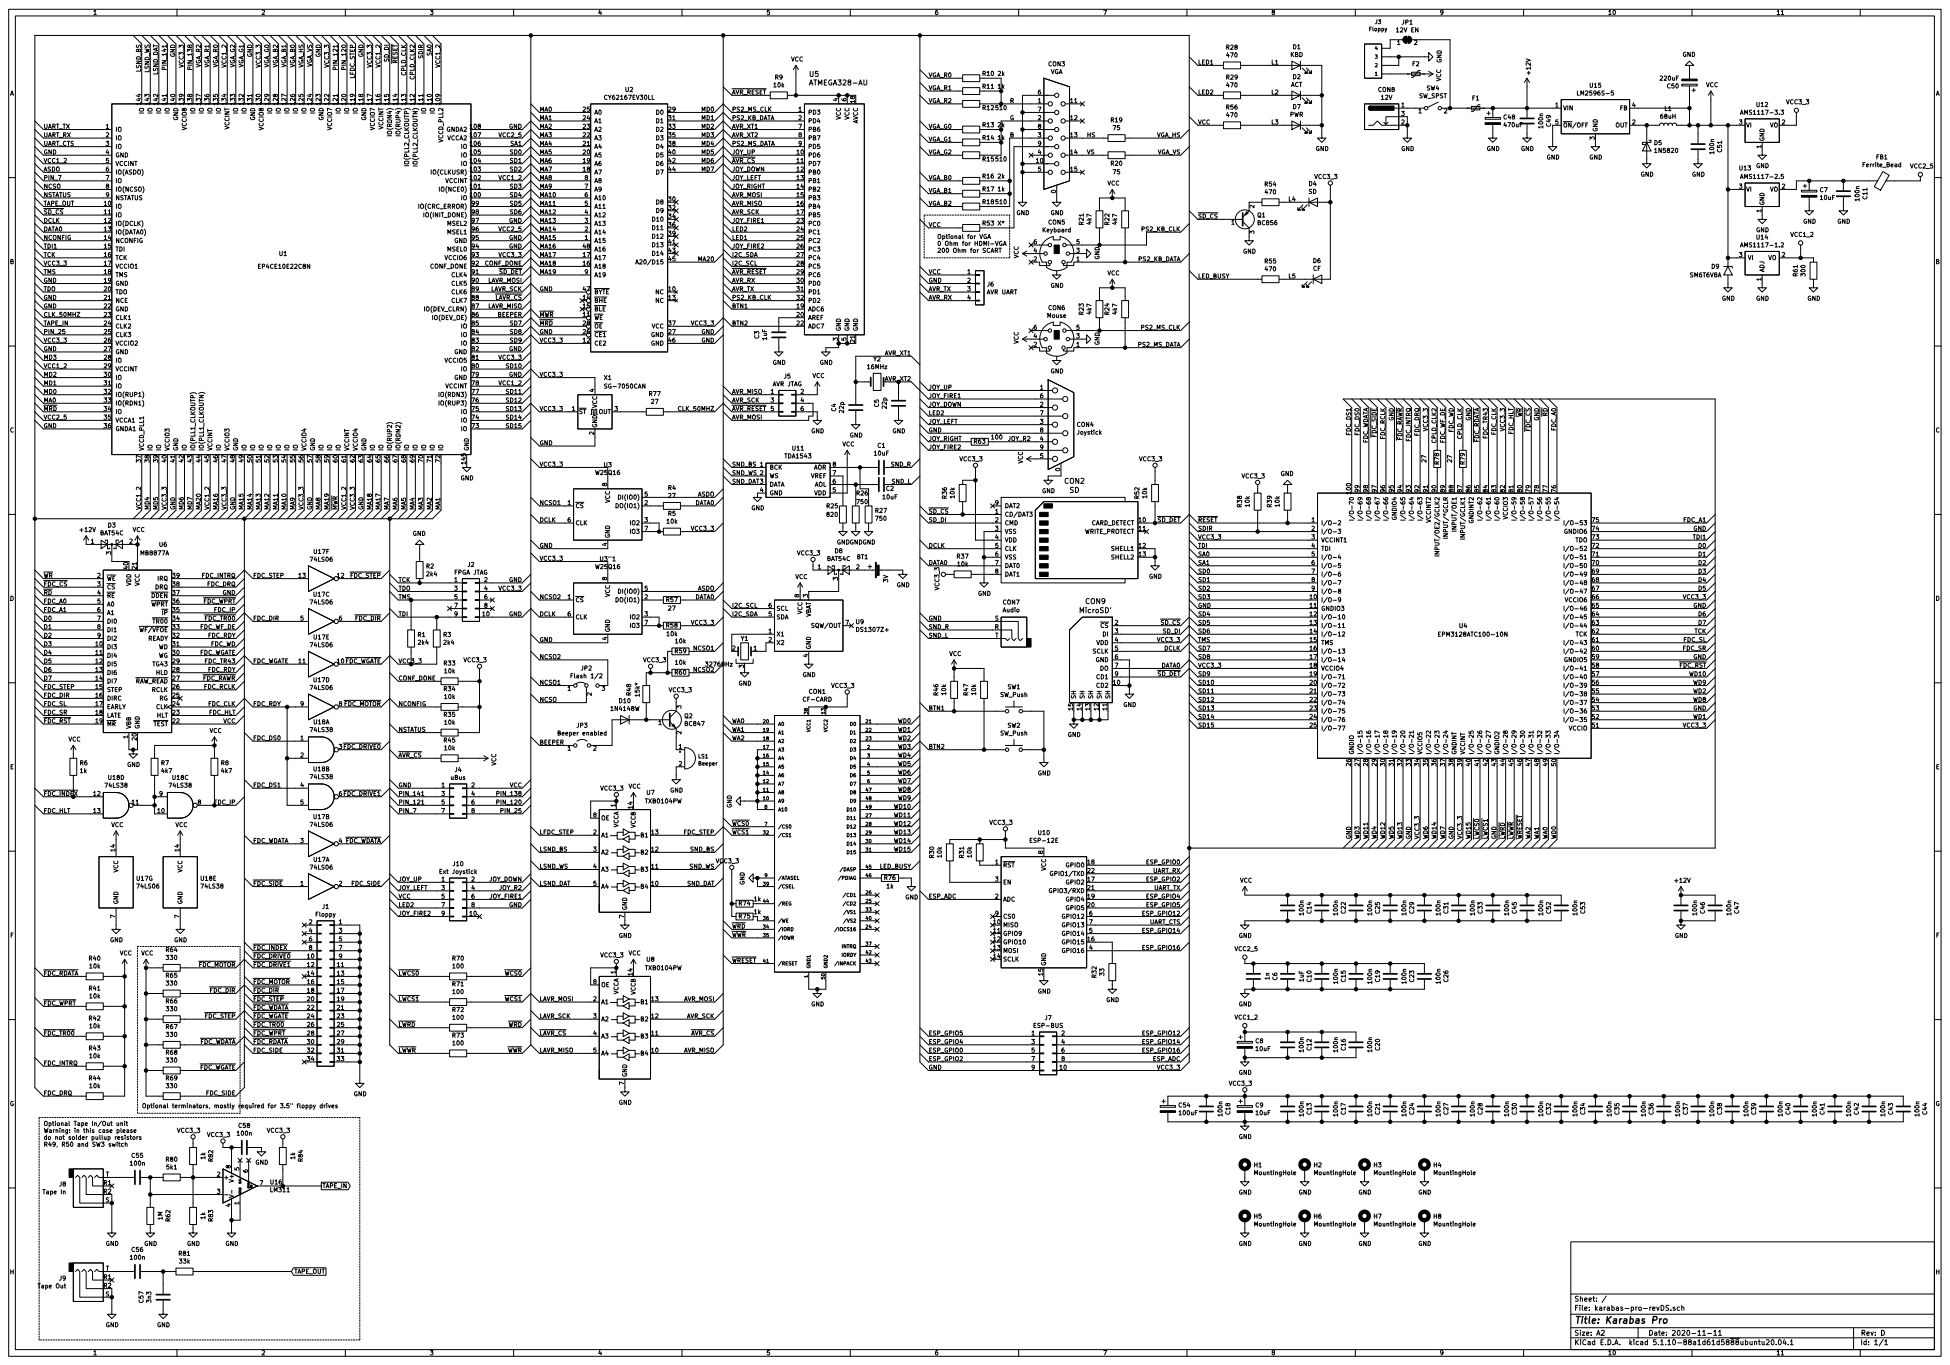
[picture p50: page 1]

6 PB6 7 PB7 8 PD5 9 PD6 10 AREF 20 PD0 30 PD7 11 GND 21 PD1 31 PB0 12 ADC7 22 PD2 32 PB1 13 PC0 23 PB2 14 PC1 24 PB3 15 PC2 25 PB4 16 PC3 26 PB5 17 PC4 27 AVCC 18 PC5 28 ADC6 19 PC6 29 U5ATMEGA328-AU

Optional for VGA
0 Ohm for HDMI-VGA
200 Ohm for SCART

File: karabas-pro-revDS.sch Sheet: / R78 27

IP 35 WPRT 36 DDEN 37 DRQ 38

4 SDA 5 SCL 6 SQW/OUT 7 VCC

H7MountingHole H3MountingHole H2MountingHole VBB
WD9 WD8 WD7 WD6 WD5 WD4 WD3 WD2 WD1 WD0 WRESET WWR Optional terminators, mostly required for 3.5" floppy drives

Optional Tape In/Out unit
Warning: in this case please
do not solder pullup resistors R49, R50 and SW3 switch

Id: 1/1 Title: Karabas Pro
