andykarpov/karabas-pro/docs/karabas-pro-revE.pdf

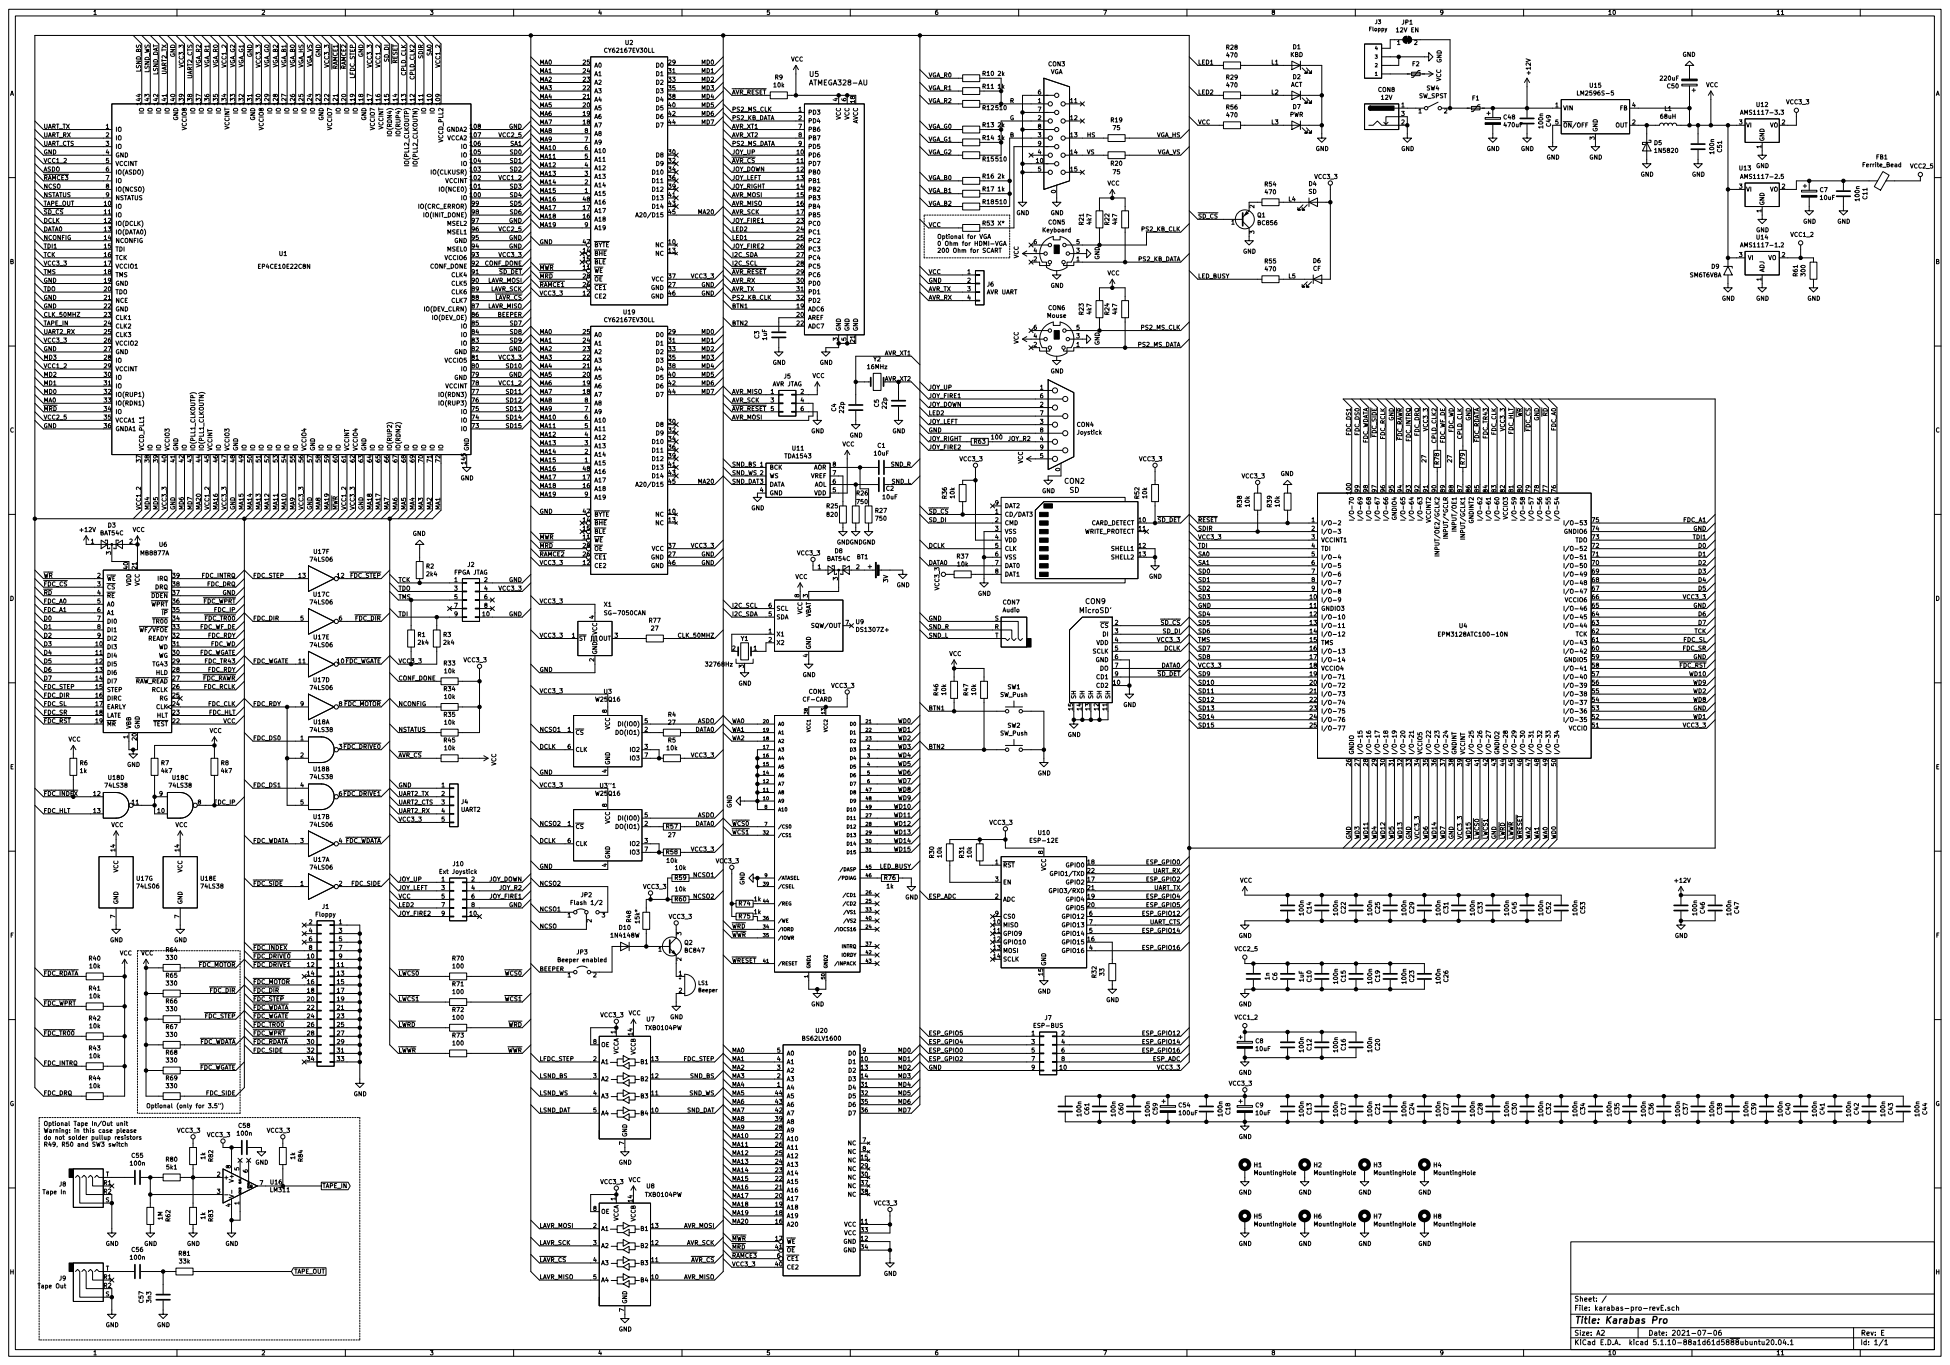
[picture p51: page 1]
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

IO 2 TDO 20 NCE 21 GND 22 CLK1 23 CLK2 24 CLK3 25 VCCIO2 26 GND 27

Optional for VGA
0 Ohm for HDMI-VGA
200 Ohm for SCART

TDI 15 TCK 16 VCCIO1 17 TMS 18 GND 19

2 3 Q2BC847 VCC3_3 GND R48 15k* A15 1 NC 10 WE 11 CE2 12 NC 13 BHE 14 BLE 15 A18 16 A17 17 A7 18 A6 19 A14 2 A5 20 A4 21 A3 22 A2 23 A1 24 A0 25 CE1 26 GND 27 OE 28 D0 29 A13 3 D8 30 D1 31 D9 32 D2 33 D10 34 D3 35 D11 36 VCC 37 D4 38 D12 39 A12 4 D5 40 D13 41 D6 42 D14 43 D7 44 A20/D15 45 GND 46 BYTE 47 A16 48 A11 5 A10 6 A9 7 A8 8 A19 9 U19 CY62167EV30LL

VCC3_3 GND GND MWR MRD

IP 35 WPRT 36 DDEN 37 DRQ 38

4 SDA 5 SCL 6 SQW/OUT 7 VCC

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

Id: 1/1 Title: Karabas Pro
