andykarpov/karabas-pro/docs/karabas-pro-tapemod_revA.pdf

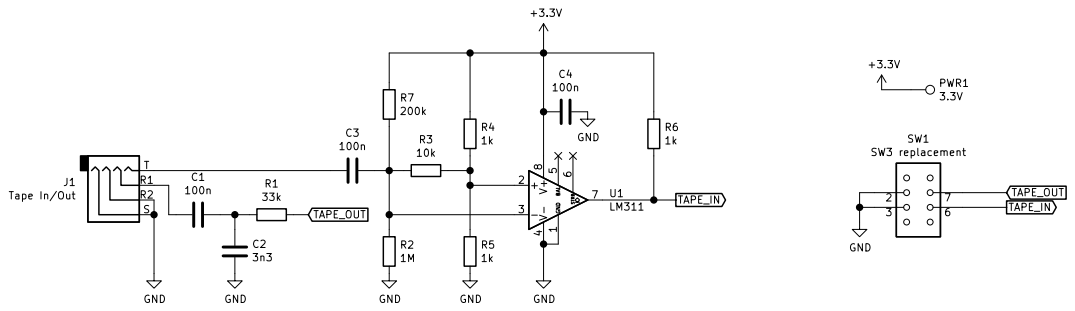
[picture p55: page 1]

File: karabas-pro-tapeMod_revA.sch Sheet: /
Id: 1/1 Title:
