andykarpov/karabas-pro/firmware/src/avr/avr.ino

/*
   AVR keyboard & mouse firmware for Karabas-Pro

   Designed to build on Arduino IDE.

   @author Andy Karpov <andy.karpov@gmail.com>
   Ukraine, 2021
*/

#include "ps2.h"
#include "matrix.h"
#include "ps2_codes.h"
#include "ps2mouse.h"
#include <RTC.h>
#include <EEPROM.h>
#include <Wire.h>
#include <SPI.h>
#include "config.h"
#include "utils.h"

PS2KeyRaw kbd;
PS2Mouse mouse(PIN_MOUSE_CLK, PIN_MOUSE_DAT);
static DS1307 rtc;

bool matrix[ZX_MATRIX_FULL_SIZE]; // matrix of pressed keys + mouse reports to be transmitted on CPLD side by simple serial protocol
bool joy[6]; // joystic states
bool last_joy[6];
bool profi_mode = true; // false = zx spectrum mode (switched by PrtSrc button in run-time)
bool is_turbo = false; // turbo toggle (switched by ScrollLock button)
bool is_mouse_swap = false; // mouse buttons swap
bool is_menu = false; // menu button pressed
bool is_ctrl = false; // Ctrl button
bool is_alt = false;  // Alt button
bool is_sw1 = false; // SW1 state
bool is_sw2 = false; // SW2 state
bool is_sw3 = false; // SW3 state
bool is_sw4 = false; // SW4 state
bool is_sw5 = false; // SW5 state
bool is_sw6 = false; // SW6 state
bool is_sw7 = false; // SW7 state
bool is_sw8 = false; // SW8 state
bool init_done = false; // init done

bool is_wait = false; // wait mode
bool mouse_present = false; // mouse present flag (detected by signal change on CLKM pin)
bool blink_state = false;
bool flags_changed = false; // changed flags is_turbo / profi_mode

bool led1_state = false;
bool led2_state = false;
bool led1_overwrite = false;
bool led2_overwrite = false;

bool ms_btn1 = false;
bool ms_btn2 = false;
bool ms_btn3 = false;

unsigned long t = 0;  // current time
unsigned long tl1, tl2 = 0; // led1/2 time
unsigned long tm = 0; // mouse poll time
unsigned long tl = 0; // blink poll time
unsigned long tr = 0; // rtc poll time
unsigned long te = 0; // eeprom store time
unsigned long tb, tb1, tb2 = 0; // hw buttons poll time
unsigned long ts = 0; // mouse swap time

int mouse_tries; // number of triers to init mouse

uint8_t mouse_x = 0; // current mouse X
uint8_t mouse_y = 0; // current mouse Y
uint8_t mouse_z = 0; // current mousr Z
uint8_t mouse_btns = 0; // mouse buttons state
bool mouse_new_packet = false; // new packet to send (toggle flag)

int rtc_year = 0;
uint8_t rtc_month = 0;
uint8_t rtc_day = 1;
uint8_t rtc_hours = 0;
uint8_t rtc_minutes = 0;
uint8_t rtc_seconds = 0;

uint8_t rtc_seconds_alarm = 0;
uint8_t rtc_minutes_alarm = 0;
uint8_t rtc_hours_alarm = 0;
uint8_t rtc_week = 1;

uint8_t rtc_last_write_reg = 0;
uint8_t rtc_last_write_data = 0;

bool rtc_init_done = false;
bool rtc_is_bcd = false;
bool rtc_is_24h = true;

int capsed_keys[20] = {0,0,0,0,0,0,0,0,0,0,0,0,0,0,0,0,0,0,0,0};
int capsed_keys_size = 0;

SPISettings settingsA(8000000, MSBFIRST, SPI_MODE0); // SPI transmission settings

void push_capsed_key(int key);
void pop_capsed_key(int key);
void process_capsed_key(int key, bool up);
void fill_kbd_matrix(int sc);
void send_macros(uint8_t pos);
uint8_t get_matrix_byte(uint8_t pos);
uint8_t get_joy_byte();
void spi_send(uint8_t addr, uint8_t data);
void transmit_keyboard_matrix();
void transmit_joy_data();
void transmit_mouse_data();
void rtc_save();
void rtc_send(uint8_t reg, uint8_t data);
void rtc_send_time();
void rtc_send_all();
void process_in_cmd(uint8_t cmd, uint8_t data);
void init_mouse();
void do_reset();
void do_full_reset();
void do_magic();
void clear_matrix(int clear_size);
bool eeprom_restore_value(int addr, bool default_value);
void eeprom_store_value(int addr, bool value);
void eeprom_restore_values();
void eeprom_store_values();
void setup();
void loop();


void push_capsed_key(int key)
{
  int i = 0;
  bool found = false;
  if (capsed_keys_size > 0) {
    for (i=0; i<capsed_keys_size; i++) {
      if (capsed_keys[i] == key) {
        found = true;
      }
    }
  }
  if (!found && capsed_keys_size < 20) {
    capsed_keys[capsed_keys_size] = key;
    capsed_keys_size++;
  }
}

void pop_capsed_key(int key)
{
  int i = 0;
  int j = 0;
  int tmp_array[20] = {0,0,0,0,0,0,0,0,0,0,0,0,0,0,0,0,0,0,0,0};
  if (capsed_keys_size > 0) {
    for (i=0; i<capsed_keys_size; i++) {
      if (capsed_keys[i] != key) {
        tmp_array[j] = capsed_keys[i];
        j++;
      }
    }
  }
  if (j > 0) {
    for (i=0; i<j; i++) {
      capsed_keys[i] = tmp_array[i];
    }
  }
  capsed_keys_size = j;
}

void process_capsed_key(int key, bool up)
{
  if (!up) {
    push_capsed_key(key);
  } else {
    pop_capsed_key(key);
  }
}

// transform PS/2 scancodes into internal matrix of pressed keys
void fill_kbd_matrix(int sc)
{

  static bool is_up = false, is_e = false, is_e1 = false;
  static bool is_del = false, is_win = false, is_bksp = false, is_shift = false, is_esc = false, is_ss_used = false;
  static int scancode = 0;

  // is extended scancode prefix
  if (sc == 0xE0) {
    is_e = 1;
    return;
  }

  if (sc == 0xE1) {
    is_e = 1;
    is_e1 = 1;
    return;
  }

  // is key released prefix
  if (sc == 0xF0 && !is_up) {
    is_up = 1;
    return;
  }

  scancode = sc + ((is_e || is_e1) ? 0x100 : 0);

  is_ss_used = false;

  matrix[ZX_K_IS_UP] = is_up;
  
  matrix[ZX_K_SCANCODE8] = bitRead(scancode, 8); // extended bit e / e1
  matrix[ZX_K_SCANCODE7] = bitRead(scancode, 7);
  matrix[ZX_K_SCANCODE6] = bitRead(scancode, 6);
  matrix[ZX_K_SCANCODE5] = bitRead(scancode, 5);
  matrix[ZX_K_SCANCODE4] = bitRead(scancode, 4);
  matrix[ZX_K_SCANCODE3] = bitRead(scancode, 3);
  matrix[ZX_K_SCANCODE2] = bitRead(scancode, 2);
  matrix[ZX_K_SCANCODE1] = bitRead(scancode, 1);
  matrix[ZX_K_SCANCODE0] = bitRead(scancode, 0);

  switch (scancode) {

    // Shift -> SS for Profi, CS for ZX
    case PS2_L_SHIFT:
    case PS2_R_SHIFT:
      matrix[profi_mode ? ZX_K_SS : ZX_K_CS] = !is_up;
      is_shift = !is_up;
      break;

    // Ctrl -> CS for Profi, SS for ZX
    case PS2_L_CTRL:
    case PS2_R_CTRL:
      matrix[profi_mode ? ZX_K_CS : ZX_K_SS] = !is_up;
      is_ctrl = !is_up;
      break;

    // Alt (L) -> SS+Enter for Profi, SS+CS for ZX
    case PS2_L_ALT:
      matrix[ZX_K_SS] = !is_up;
      matrix[profi_mode ? ZX_K_ENT : ZX_K_CS] = !is_up;
      if (!profi_mode) {
        process_capsed_key(scancode, is_up);
      }
      is_alt = !is_up;
      break;

    // Alt (R) -> SS + Space for Profi, SS+CS for ZX
    case PS2_R_ALT:
      matrix[ZX_K_SS] = !is_up;
      matrix[profi_mode ? ZX_K_SP : ZX_K_CS] = !is_up;
      if (!profi_mode) {
        process_capsed_key(scancode, is_up);
      }
      is_alt = !is_up;
      break;

    // Del -> P+b6 for Profi, SS+C for ZX
    case PS2_DELETE:
      if (!is_shift) {
        if (profi_mode) {
          matrix[ZX_K_P] = !is_up;
          matrix[ZX_K_BIT6] = !is_up;
        } else {
          matrix[ZX_K_SS] = !is_up;
          matrix[ZX_K_C] =  !is_up;
        }
        is_del = !is_up;
      }
      break;

    // Win
    case PS2_L_WIN:
    case PS2_R_WIN:
      is_win = !is_up;
      break;

    // Menu
    case PS2_MENU:
      is_menu = !is_up;
      break;

    // Ins -> O+b6 for Profi, SS+A for ZX
    case PS2_INSERT:
      if (!is_shift) {
        if (profi_mode) {
          matrix[ZX_K_O] = !is_up;
          matrix[ZX_K_BIT6] = !is_up;
        } else {
          matrix[ZX_K_SS] = !is_up;
          matrix[ZX_K_A] =  !is_up;
        }
      }
      break;

    // Cursor -> CS + 5,6,7,8
    case PS2_UP:
      if (!is_shift) {
        matrix[ZX_K_CS] = !is_up;
        matrix[ZX_K_7] = !is_up;
        process_capsed_key(scancode, is_up);
      }
      break;
    case PS2_DOWN:
      if (!is_shift) {
        matrix[ZX_K_CS] = !is_up;
        matrix[ZX_K_6] = !is_up;
        process_capsed_key(scancode, is_up);
      }
      break;
    case PS2_LEFT:
      if (!is_shift) {
        matrix[ZX_K_CS] = !is_up;
        matrix[ZX_K_5] = !is_up;
        process_capsed_key(scancode, is_up);
      }
      break;
    case PS2_RIGHT:
      if (!is_shift) {
        matrix[ZX_K_CS] = !is_up;
        matrix[ZX_K_8] = !is_up;
        process_capsed_key(scancode, is_up);
      }
      break;

    // ESC -> CS+1 for Profi, CS+SPACE for ZX
    case PS2_ESC:
      matrix[ZX_K_CS] = !is_up;
      matrix[profi_mode ? ZX_K_1 : ZX_K_SP] = !is_up;
      process_capsed_key(scancode, is_up);
      is_esc = !is_up;
      break;

    // Backspace -> CS+0
    case PS2_BACKSPACE:
      matrix[ZX_K_CS] = !is_up;
      matrix[ZX_K_0] = !is_up;
      process_capsed_key(scancode, is_up);
      is_bksp = !is_up;
      break;

    // Enter
    case PS2_ENTER:
    case PS2_KP_ENTER:
      matrix[ZX_K_ENT] = !is_up;
      break;

    // Space
    case PS2_SPACE:
      matrix[ZX_K_SP] = !is_up;
      break;

    // Letters & numbers
    case PS2_A: matrix[ZX_K_A] = !is_up; break;
    case PS2_B: matrix[ZX_K_B] = !is_up; break;
    case PS2_C: matrix[ZX_K_C] = !is_up; break;
    case PS2_D: matrix[ZX_K_D] = !is_up; break;
    case PS2_E: matrix[ZX_K_E] = !is_up; break;
    case PS2_F: matrix[ZX_K_F] = !is_up; break;
    case PS2_G: matrix[ZX_K_G] = !is_up; break;
    case PS2_H: matrix[ZX_K_H] = !is_up; break;
    case PS2_I: matrix[ZX_K_I] = !is_up; break;
    case PS2_J: matrix[ZX_K_J] = !is_up; break;
    case PS2_K: matrix[ZX_K_K] = !is_up; break;
    case PS2_L: matrix[ZX_K_L] = !is_up; break;
    case PS2_M: matrix[ZX_K_M] = !is_up; break;
    case PS2_N: matrix[ZX_K_N] = !is_up; break;
    case PS2_O: matrix[ZX_K_O] = !is_up; break;
    case PS2_P: matrix[ZX_K_P] = !is_up; break;
    case PS2_Q: matrix[ZX_K_Q] = !is_up; break;
    case PS2_R: matrix[ZX_K_R] = !is_up; break;
    case PS2_S: matrix[ZX_K_S] = !is_up; break;
    case PS2_T: matrix[ZX_K_T] = !is_up; break;
    case PS2_U: matrix[ZX_K_U] = !is_up; break;
    case PS2_V: matrix[ZX_K_V] = !is_up; break;
    case PS2_W: matrix[ZX_K_W] = !is_up; break;
    case PS2_X: matrix[ZX_K_X] = !is_up; break;
    case PS2_Y: matrix[ZX_K_Y] = !is_up; break;
    case PS2_Z: matrix[ZX_K_Z] = !is_up; break;

    // digits
    case PS2_0: matrix[ZX_K_0] = !is_up; break;
    case PS2_1: matrix[ZX_K_1] = !is_up; break;
    case PS2_2: matrix[ZX_K_2] = !is_up; break;
    case PS2_3: matrix[ZX_K_3] = !is_up; break;
    case PS2_4: matrix[ZX_K_4] = !is_up; break;
    case PS2_5: matrix[ZX_K_5] = !is_up; break;
    case PS2_6: matrix[ZX_K_6] = !is_up; break;
    case PS2_7: matrix[ZX_K_7] = !is_up; break;
    case PS2_8: matrix[ZX_K_8] = !is_up; break;
    case PS2_9: matrix[ZX_K_9] = !is_up; break;

    // Keypad digits
    case PS2_KP_0: matrix[ZX_K_0] = !is_up; break;
    case PS2_KP_1: matrix[ZX_K_1] = !is_up; break;
    case PS2_KP_2: matrix[ZX_K_2] = !is_up; break;
    case PS2_KP_3: matrix[ZX_K_3] = !is_up; break;
    case PS2_KP_4: matrix[ZX_K_4] = !is_up; break;
    case PS2_KP_5: matrix[ZX_K_5] = !is_up; break;
    case PS2_KP_6: matrix[ZX_K_6] = !is_up; break;
    case PS2_KP_7: matrix[ZX_K_7] = !is_up; break;
    case PS2_KP_8: matrix[ZX_K_8] = !is_up; break;
    case PS2_KP_9: matrix[ZX_K_9] = !is_up; break;

    // '/" -> SS+P / SS+7
    case PS2_QUOTE:
      matrix[ZX_K_SS] = !is_up;
      matrix[is_shift ? ZX_K_P : ZX_K_7] = !is_up;
      if (is_up) {
        matrix[ZX_K_P] = false;
        matrix[ZX_K_7] = false;
      }
      is_ss_used = is_shift;
      break;

    // ,/< -> SS+N / SS+R
    case PS2_COMMA:
      matrix[ZX_K_SS] = !is_up;
      matrix[is_shift ? ZX_K_R : ZX_K_N] = !is_up;
      if (is_up) {
        matrix[ZX_K_R] = false;
        matrix[ZX_K_N] = false;
      }
      is_ss_used = is_shift;
      break;

    // ./> -> SS+M / SS+T
    case PS2_PERIOD:
    case PS2_KP_PERIOD:
      matrix[ZX_K_SS] = !is_up;
      matrix[is_shift ? ZX_K_T : ZX_K_M] = !is_up;
      if (is_up) {
        matrix[ZX_K_T] = false;
        matrix[ZX_K_M] = false;
      }
      is_ss_used = is_shift;
      break;

    // ;/: -> SS+O / SS+Z
    case PS2_SEMICOLON:
      matrix[ZX_K_SS] = !is_up;
      matrix[is_shift ? ZX_K_Z : ZX_K_O] = !is_up;
      if (is_up) {
        matrix[ZX_K_Z] = false;
        matrix[ZX_K_O] = false;
      }
      is_ss_used = is_shift;
      break;

    // [,{ -> SS+Y / SS+F
    case PS2_L_BRACKET:
      if (!profi_mode) {
        if (!is_up) {
          send_macros(is_shift ? ZX_K_F : ZX_K_Y);
        }
      } else {
        matrix[ZX_K_SS] = !is_up;
        matrix[is_shift ? ZX_K_F : ZX_K_Y] = !is_up;
        if (is_up) {
          matrix[ZX_K_F] = false;
          matrix[ZX_K_Y] = false;
        }
      }
      break;

    // ],} -> SS+U / SS+G
    case PS2_R_BRACKET:
      if (!profi_mode) {
        if (!is_up) {
          send_macros(is_shift ? ZX_K_G : ZX_K_U);
        }
      } else {
        matrix[ZX_K_SS] = !is_up;
        matrix[is_shift ? ZX_K_G : ZX_K_U] = !is_up;
        if (is_up) {
          matrix[ZX_K_G] = false;
          matrix[ZX_K_U] = false;
        }
      }
      break;

    // /,? -> SS+V / SS+C
    case PS2_SLASH:
    case PS2_KP_SLASH:
      matrix[ZX_K_SS] = !is_up;
      matrix[is_shift ? ZX_K_C : ZX_K_V] = !is_up;
      if (is_up) {
        matrix[ZX_K_C] = false;
        matrix[ZX_K_V] = false;
      }
      is_ss_used = is_shift;
      break;

    // \,| -> SS+D / SS+S
    case PS2_BACK_SLASH:
      if (!profi_mode) {
        if (!is_up) {
          send_macros(is_shift ? ZX_K_S : ZX_K_D);
        }
      } else {
        matrix[ZX_K_SS] = !is_up;
        matrix[is_shift ? ZX_K_S : ZX_K_D] = !is_up;
        if (is_up) {
          matrix[ZX_K_S] = false;
          matrix[ZX_K_D] = false;
        }
      }
      break;

    // =,+ -> SS+L / SS+K
    case PS2_EQUALS:
      matrix[ZX_K_SS] = !is_up;
      matrix[is_shift ? ZX_K_K : ZX_K_L] = !is_up;
      if (is_up) {
        matrix[ZX_K_K] = false;
        matrix[ZX_K_L] = false;
      }
      is_ss_used = is_shift;
      break;

    // -,_ -> SS+J / SS+0
    case PS2_MINUS:
      matrix[ZX_K_SS] = !is_up;
      matrix[is_shift ? ZX_K_0 : ZX_K_J] = !is_up;
      if (is_up) {
        matrix[ZX_K_0] = false;
        matrix[ZX_K_J] = false;
      }
      is_ss_used = is_shift;
      break;

    // `,~ -> SS+X / SS+A
    case PS2_ACCENT:
      if (is_shift and !is_up) {
        send_macros(is_shift ? ZX_K_A : ZX_K_X);
      }
      if (!is_shift) {
        matrix[ZX_K_SS] = !is_up;
        matrix[ZX_K_X] = !is_up;
      }
      is_ss_used = is_shift;
      break;

    // Keypad * -> SS+B
    case PS2_KP_STAR:
      matrix[ZX_K_SS] = !is_up;
      matrix[ZX_K_B] = !is_up;
      break;

    // Keypad - -> SS+J
    case PS2_KP_MINUS:
      matrix[ZX_K_SS] = !is_up;
      matrix[ZX_K_J] = !is_up;
      break;

    // Keypad + -> SS+K
    case PS2_KP_PLUS:
      matrix[ZX_K_SS] = !is_up;
      matrix[ZX_K_K] = !is_up;
      break;

    // Tab
    case PS2_TAB:
      matrix[ZX_K_CS] = !is_up;
      matrix[ZX_K_I] = !is_up;
      process_capsed_key(scancode, is_up);
      break;

    // CapsLock
    case PS2_CAPS:
      matrix[ZX_K_SS] = !is_up;
      matrix[ZX_K_CS] = !is_up;
      process_capsed_key(scancode, is_up);
      break;

    // PgUp -> M+BIT6 for Profi, CS+3 for ZX
    case PS2_PGUP:
      if (!is_shift) {
        if (profi_mode) {
          matrix[ZX_K_M] = !is_up;
          matrix[ZX_K_BIT6] = !is_up;
        } else {
          matrix[ZX_K_CS] = !is_up;
          matrix[ZX_K_3] = !is_up;
          process_capsed_key(scancode, is_up);
        }
      }
      break;

    // PgDn -> N+BIT6 for Profi, CS+4 for ZX
    case PS2_PGDN:
      if (!is_shift) {
        if (profi_mode) {
          matrix[ZX_K_N] = !is_up;
          matrix[ZX_K_BIT6] = !is_up;
        } else {
          matrix[ZX_K_CS] = !is_up;
          matrix[ZX_K_4] = !is_up;
          process_capsed_key(scancode, is_up);
        }
      }
      break;

    // Home -> K+BIT6 for Profi
    case PS2_HOME:
      if (!is_shift) {
        matrix[ZX_K_K] = !is_up;
        matrix[ZX_K_BIT6] = !is_up;
      }
      break;

    // End -> L+BIT6 for Profi
    case PS2_END:
      if (!is_shift) {
        matrix[ZX_K_L] = !is_up;
        matrix[ZX_K_BIT6] = !is_up;
      }
      break;

    // Fn keys
    case PS2_F1:
      if (is_menu || (is_ctrl && is_alt)) {
        if (!is_up) {
          // menu + F1, ctrl+alt = ROMSET 00
          is_sw3 = false;
          is_sw4 = false;
          eeprom_store_value(EEPROM_SW3_ADDRESS, is_sw3);
          eeprom_store_value(EEPROM_SW4_ADDRESS, is_sw4);
          matrix[ZX_K_SW3] = is_sw3;
          matrix[ZX_K_SW4] = is_sw4;
        }
      } else {
        matrix[ZX_K_A] = !is_up; matrix[ZX_K_BIT6] = !is_up;
      }
      break;
    case PS2_F2:
      if (is_menu || (is_ctrl && is_alt)) {
        if (!is_up) {
          // menu + F2 = ROMSET 01
          is_sw3 = true;
          is_sw4 = false;
          eeprom_store_value(EEPROM_SW3_ADDRESS, is_sw3);
          eeprom_store_value(EEPROM_SW4_ADDRESS, is_sw4);
          matrix[ZX_K_SW3] = is_sw3;
          matrix[ZX_K_SW4] = is_sw4;
        }
      } else {
        matrix[ZX_K_B] = !is_up; matrix[ZX_K_BIT6] = !is_up; 
      }
      break;
    case PS2_F3:
      if (is_menu || (is_ctrl && is_alt)) {
        if (!is_up) {
          // menu + F3 = ROMSET 10
          is_sw3 = false;
          is_sw4 = true;
          eeprom_store_value(EEPROM_SW3_ADDRESS, is_sw3);
          eeprom_store_value(EEPROM_SW4_ADDRESS, is_sw4);
          matrix[ZX_K_SW3] = is_sw3;
          matrix[ZX_K_SW4] = is_sw4;
        }
      } else {
        matrix[ZX_K_C] = !is_up; matrix[ZX_K_BIT6] = !is_up; 
      }
      break;
    case PS2_F4:
      if (is_menu || (is_ctrl && is_alt)) {
        if (!is_up) {
          // menu + F4 = ROMSET 11
          is_sw3 = true;
          is_sw4 = true;
          eeprom_store_value(EEPROM_SW3_ADDRESS, is_sw3);
          eeprom_store_value(EEPROM_SW4_ADDRESS, is_sw4);
          matrix[ZX_K_SW3] = is_sw3;
          matrix[ZX_K_SW4] = is_sw4;          
        }
      } else {
        matrix[ZX_K_D] = !is_up; matrix[ZX_K_BIT6] = !is_up; 
      }
      break;
    case PS2_F5:
      if (is_menu || (is_ctrl && is_alt)) {
        if (!is_up) {
          // menu + F5 = SW5
          is_sw5 = !is_sw5;
          eeprom_store_value(EEPROM_SW5_ADDRESS, is_sw5);
          matrix[ZX_K_SW5] = is_sw5;
        }
      } else {
        matrix[ZX_K_E] = !is_up; matrix[ZX_K_BIT6] = !is_up; 
      }
      break;

    case PS2_F6: 
      if (is_menu || (is_ctrl && is_alt)) {
        if (!is_up) {
          // menu + F6 = SW6
          is_sw6 = !is_sw6;
          eeprom_store_value(EEPROM_SW6_ADDRESS, is_sw6);
          matrix[ZX_K_SW6] = is_sw6;
        }
      } else {
        matrix[ZX_K_F] = !is_up; matrix[ZX_K_BIT6] = !is_up;
      }
      break;
    case PS2_F7: 
      if (is_menu || (is_ctrl && is_alt)) {
        if (!is_up) {
          // menu + F7 = SW7
          is_sw7 = !is_sw7;
          eeprom_store_value(EEPROM_SW7_ADDRESS, is_sw7);
          matrix[ZX_K_SW7] = is_sw7;
        }
      } else {
        matrix[ZX_K_G] = !is_up; matrix[ZX_K_BIT6] = !is_up; 
      }
      break;
    case PS2_F8: 
      if (is_menu || (is_ctrl && is_alt)) {
        if (!is_up) {
          // menu + F8 = SW8
          is_sw8 = !is_sw8;
          eeprom_store_value(EEPROM_SW8_ADDRESS, is_sw8);
          matrix[ZX_K_SW8] = is_sw8;
        }
      } else {
        matrix[ZX_K_H] = !is_up; matrix[ZX_K_BIT6] = !is_up;
      }
      break;
    case PS2_F9: 
      if (is_menu || (is_ctrl && is_alt)) {
        if (!is_up) {
          // menu + F9 = SW1
          is_sw1 = !is_sw1;
          eeprom_store_value(EEPROM_SW1_ADDRESS, is_sw1);
          matrix[ZX_K_SW1] = is_sw1;
        }
      } else {
          matrix[ZX_K_I] = !is_up; matrix[ZX_K_BIT6] = !is_up;
      }
      break;
    case PS2_F10: 
      if (is_menu || (is_ctrl && is_alt)) {
        if (!is_up) {
          // menu + F10 = SW2
          is_sw2 = !is_sw2;
          eeprom_store_value(EEPROM_SW2_ADDRESS, is_sw2);
          matrix[ZX_K_SW2] = is_sw2;
        }
      } else {
        matrix[ZX_K_J] = !is_up; matrix[ZX_K_BIT6] = !is_up;
      }
      break;    
    case PS2_F11:
      if (is_menu || (is_ctrl && is_alt)) {
        if (!is_up) {
          // menu + F11 = turbo
          is_turbo = !is_turbo;
          eeprom_store_value(EEPROM_TURBO_ADDRESS, is_turbo);
          matrix[ZX_K_TURBO] = is_turbo;
        }
      } else {
        matrix[ZX_K_Q] = !is_up; matrix[ZX_K_SS] = !is_up;
      }
      break;
    case PS2_F12:
      if (is_menu || (is_ctrl && is_alt)) {
        if (!is_up) {
          // menu + F12 = magic
          do_magic();
        }
      } else {
        matrix[ZX_K_W] = !is_up; matrix[ZX_K_SS] = !is_up;
      }
      break;

    // Scroll Lock -> Nothing
    case PS2_SCROLL:
      // TODO
    break;

    // PrtScr -> Mode profi / zx
    case PS2_PSCR1:
      if (!is_shift) {
        if (is_up) {
          profi_mode = !profi_mode;
          eeprom_store_value(EEPROM_MODE_ADDRESS, profi_mode);
          matrix[ZX_K_KBD_MODE] = profi_mode;
        }
      }
    break;

    // Pause -> Wait
    case PS2_PAUSE:
      if (is_up) {
        is_wait = !is_wait;
        matrix[ZX_K_WAIT] = is_wait;
      }      
    break;

      // TODO:
      // Windows L / Home -> SS+F
      // Windiws R / End -> SS+G

  }

  if (is_ss_used && capsed_keys_size == 0) {
    matrix[ZX_K_CS] = false;
  }
  
  if (capsed_keys_size > 0) {
    matrix[ZX_K_CS] = true;
  }

  // Ctrl+Alt+Del -> RESET
  if (is_ctrl && is_alt && is_del) {
    is_ctrl = false;
    is_alt = false;
    is_del = false;
    is_shift = false;
    is_ss_used = false;
    capsed_keys_size = 0;
    do_reset();
  }
  //digitalWrite(PIN_RESET, (is_ctrl && is_alt && is_del) ? LOW : HIGH);

  // Ctrl+Alt+Esc -> MAGIC
  if (is_ctrl && is_alt && is_esc) {
    is_ctrl = false;
    is_alt = false;
    is_esc = false;
    is_shift = false;
    is_ss_used = false;
    capsed_keys_size = 0;
    do_magic();
  }

  // Ctrl+Alt+Bksp -> REINIT controller
  if (is_ctrl && is_alt && is_bksp) {
    is_ctrl = false;
    is_alt = false;
    is_bksp = false;
    is_shift = false;
    is_ss_used = false;
    capsed_keys_size = 0;
    do_full_reset();
  }

  // clear flags
  is_up = 0;
  if (is_e1) {
    is_e1 = 0;
  } else {
    is_e = 0;
  }
}

// transmit keyboard macros (sequence of keyboard clicks) to emulate typing some special symbols [, ], {, }, ~, |, `
void send_macros(uint8_t pos)
{
  clear_matrix(ZX_MATRIX_SIZE);
  transmit_keyboard_matrix();
  delay(20);
  matrix[ZX_K_CS] = true;
  transmit_keyboard_matrix();
  delay(20);
  matrix[ZX_K_SS] = true;
  transmit_keyboard_matrix();
  delay(20);
  matrix[ZX_K_SS] = false;
  transmit_keyboard_matrix();
  delay(20);
  matrix[pos] = true;
  transmit_keyboard_matrix();
  delay(20);
  matrix[ZX_K_CS] = false;
  matrix[pos] = false;
  transmit_keyboard_matrix();
  delay(20);
}

uint8_t get_matrix_byte(uint8_t pos)
{
  uint8_t result = 0;
  for (uint8_t i = 0; i < 8; i++) {
    uint8_t k = pos * 8 + i;
    if (k < ZX_MATRIX_FULL_SIZE) {
      bitWrite(result, i, matrix[k]);
    }
  }
  return result;
}

uint8_t get_joy_byte()
{
  uint8_t result = 0;
  for (uint8_t i = 0; i < 6; i++) {
    bitWrite(result, i, joy[i]);
  }
  return result;
}

void spi_send(uint8_t addr, uint8_t data)
{
  SPI.beginTransaction(settingsA);
  digitalWrite(PIN_SS, LOW);
  uint8_t cmd = SPI.transfer(addr); // command (1...6)
  uint8_t res = SPI.transfer(data); // data byte
  digitalWrite(PIN_SS, HIGH);
  SPI.endTransaction();
  if (cmd > 0) {
    process_in_cmd(cmd, res);
  }
}

// transmit keyboard matrix from AVR to CPLD side via SPI
void transmit_keyboard_matrix()
{
  uint8_t bytes = 8;
  for (uint8_t i = 0; i < bytes; i++) {
    uint8_t data = get_matrix_byte(i);
    spi_send(i + 1, data);
  }
}

void transmit_joy_data()
{
  uint8_t data = get_joy_byte();
  spi_send(CMD_JOY, data);
}

void transmit_mouse_data()
{
  uint8_t cmd = 0;
  uint8_t res = 0;

  spi_send(CMD_MOUSE_X, mouse_x);
  spi_send(CMD_MOUSE_Y, mouse_y);
  spi_send(CMD_MOUSE_Z, mouse_z);
}

void rtc_save() {
  rtc.setHourMode(CLOCK_H24);
  rtc.setDay(rtc_day);
  rtc.setMonth(rtc_month);
  rtc.setYear(rtc_year);
  rtc.setWeek(rtc_week);
  rtc.setHours(rtc_hours);
  rtc.setMinutes(rtc_minutes);
  rtc.setSeconds(rtc_seconds);
}

void rtc_send(uint8_t reg, uint8_t data) {
  spi_send(CMD_RTC_READ + reg, data);
}


void rtc_send_time() {
  uint8_t data;
  //data = EEPROM.read(EEPROM_RTC_OFFSET + 0xA); bitClear(data, 7); rtc_send(0xA, data);
  //data = EEPROM.read(EEPROM_RTC_OFFSET + 0xB); rtc_send(0xB, data);
  rtc_send(0, rtc_is_bcd ? bin2bcd(rtc_seconds) : rtc_seconds);
  rtc_send(2, rtc_is_bcd ? bin2bcd(rtc_minutes) : rtc_minutes);
  rtc_send(4, rtc_is_24h ? (rtc_is_bcd ? bin2bcd(rtc_hours) : rtc_hours) : (rtc_is_bcd ? bin2bcd(time_to12h(rtc_hours)) : time_to12h(rtc_hours)));
  rtc_send(6, rtc_is_bcd ? bin2bcd(rtc_week) : rtc_week);
  rtc_send(7, rtc_is_bcd ? bin2bcd(rtc_day) : rtc_day);
  rtc_send(8, rtc_is_bcd ? bin2bcd(rtc_month) : rtc_month);
  rtc_send(9, rtc_is_bcd ? bin2bcd(get_year(rtc_year)) : get_year(rtc_year));
}

void rtc_send_all() {
  uint8_t data;
  for (uint8_t reg = 0; reg < 64; reg++) {
    switch (reg) {
      case 0: rtc_send(reg, rtc_is_bcd ? bin2bcd(rtc_seconds) : rtc_seconds); break;
      case 1: rtc_send(reg, rtc_is_bcd ? bin2bcd(rtc_seconds_alarm) : rtc_seconds_alarm); break;
      case 2: rtc_send(reg, rtc_is_bcd ? bin2bcd(rtc_minutes) : rtc_minutes); break;
      case 3: rtc_send(reg, rtc_is_bcd ? bin2bcd(rtc_minutes_alarm) : rtc_minutes_alarm); break;
      case 4: rtc_send(reg, rtc_is_24h ? (rtc_is_bcd ? bin2bcd(rtc_hours) : rtc_hours) : (rtc_is_bcd ? bin2bcd(time_to12h(rtc_hours)) : time_to12h(rtc_hours))); break;
      case 5: rtc_send(reg, rtc_is_24h ? (rtc_is_bcd ? bin2bcd(rtc_hours_alarm) : rtc_hours_alarm) : (rtc_is_bcd ? bin2bcd(time_to12h(rtc_hours_alarm)) : time_to12h(rtc_hours_alarm))); break;
      case 6: rtc_send(reg, rtc_is_bcd ? bin2bcd(rtc_week) : rtc_week); break;
      case 7: rtc_send(reg, rtc_is_bcd ? bin2bcd(rtc_day) : rtc_day); break;
      case 8: rtc_send(reg, rtc_is_bcd ? bin2bcd(rtc_month) : rtc_month); break;
      case 9: rtc_send(reg, rtc_is_bcd ? bin2bcd(get_year(rtc_year)) : get_year(rtc_year)); break;
      case 0xA: data = EEPROM.read(EEPROM_RTC_OFFSET + reg); bitClear(data, 7); rtc_send(reg, data); break;
      case 0xB: data = EEPROM.read(EEPROM_RTC_OFFSET + reg); rtc_send(reg, data); break;
      case 0xC: rtc_send(reg, 0x0); break;
      case 0xD: rtc_send(reg, 0x80); break;
      default: rtc_send(reg, EEPROM.read(EEPROM_RTC_OFFSET + reg));
    }
  }
}

void process_in_cmd(uint8_t cmd, uint8_t data)
{
  uint8_t reg;

  if (cmd == CMD_INIT_REQ && !init_done) {
      Serial.print(F("FPGA init request..."));
      init_done = true;
      transmit_keyboard_matrix();
      rtc_send_all();
      do_reset();
      Serial.println(F("done"));
      Serial.print(F("FPGA board revision is: "));
      switch (data) {
        case 0:
          Serial.println(F("Rev.A with TDA1543 DAC"));
        break;
        case 1:
          Serial.println(F("Rev.A with TDA1543A DAC"));
        break;
        case 2:
          Serial.println(F("Rev.C"));
        break;
        default:
          Serial.println(F("Unknown"));
      }
  }

  if (cmd == CMD_RTC_INIT_REQ && !rtc_init_done) {
    Serial.print(F("RTC init request..."));
    rtc_init_done = true;
    rtc_send_all();
    Serial.println(F("done"));
  }

  if (cmd == CMD_LED_WRITE) {
    led1_state = bitRead(data, 0);
    led2_state = bitRead(data, 1);
    led1_overwrite = bitRead(data, 2);
    led2_overwrite = bitRead(data, 3);
  }

  if (cmd >= CMD_RTC_WRITE && cmd < CMD_RTC_WRITE + 64) {
    // write rtc register
    reg = cmd - CMD_RTC_WRITE;

    // skip double write
    if (rtc_last_write_reg == reg && rtc_last_write_data == data) return;

    rtc_last_write_reg = reg;
    rtc_last_write_data = data;

    switch (reg) {
      case 0: rtc_seconds = rtc_is_bcd ? bcd2bin(data) : data; rtc.setSeconds(rtc_seconds); break;
      case 1: rtc_seconds_alarm = rtc_is_bcd ? bcd2bin(data) : data; break;
      case 2: rtc_minutes = rtc_is_bcd ? bcd2bin(data) : data; rtc.setMinutes(rtc_minutes); break;
      case 3: rtc_minutes_alarm = rtc_is_bcd ? bcd2bin(data) : data;  break;
      case 4: rtc_hours = rtc_is_bcd ? bcd2bin(data) : data; rtc.setHourMode(CLOCK_H24); rtc.setHours(rtc_hours); break;
      case 5: rtc_hours_alarm = rtc_is_bcd ? bcd2bin(data) : data; break;
      case 6: rtc_week = rtc_is_bcd ? bcd2bin(data) : data; rtc.setWeek(rtc_week); break;
      case 7: rtc_day = rtc_is_bcd ? bcd2bin(data) : data; rtc.setDay(rtc_day); break;
      case 8: rtc_month = rtc_is_bcd ? bcd2bin(data) : data; rtc.setMonth(rtc_month); break;
      case 9: rtc_year = 2000 + (rtc_is_bcd ? bcd2bin(data) : data); rtc.setYear(rtc_year); break;
      case 0xA: bitClear(data, 7); EEPROM.write(EEPROM_RTC_OFFSET + reg, data); break;
      case 0xB: rtc_is_bcd = !bitRead(data, 2); rtc_is_24h = bitRead(data, 1); EEPROM.write(EEPROM_RTC_OFFSET + reg, data); break;
      case 0xC: // C and D are read-only registers
      case 0xD: break;
      default: EEPROM.write(EEPROM_RTC_OFFSET + reg, data);
    }
  }
}

void init_mouse()
{
#if (MOUSE_POLL_TYPE == 1)
  mouse_present = mouse.initialize();
#else 
  mouse_present = mouse.streamInitialize();
#endif
}

void do_reset()
{
  clear_matrix(ZX_MATRIX_SIZE);
  matrix[ZX_K_RESET] = 1;
  transmit_keyboard_matrix();
  delay(100);
  clear_matrix(ZX_MATRIX_SIZE);
  matrix[ZX_K_RESET] = 0;
  transmit_keyboard_matrix();
}

void do_full_reset()
{
  clear_matrix(ZX_MATRIX_SIZE);
  matrix[ZX_K_RESET] = 1;
  transmit_keyboard_matrix();
  matrix[ZX_K_S] = 1;
  transmit_keyboard_matrix();
  delay(500);
  matrix[ZX_K_RESET] = 0;
  transmit_keyboard_matrix();
  delay(500);
  matrix[ZX_K_S] = 0;
  //setup();
}

void do_magic()
{
  clear_matrix(ZX_MATRIX_SIZE);
  matrix[ZX_K_MAGICK] = 1;
  transmit_keyboard_matrix();
  delay(100);
  clear_matrix(ZX_MATRIX_SIZE);
  matrix[ZX_K_MAGICK] = 0;
  transmit_keyboard_matrix();
}

void clear_matrix(int clear_size)
{
  // all keys up
  for (int i = 0; i < clear_size; i++) {
    matrix[i] = false;
  }
}

bool eeprom_restore_value(int addr, bool default_value)
{
  byte val;
  val = EEPROM.read(addr);
  if ((val == EEPROM_VALUE_TRUE) || (val == EEPROM_VALUE_FALSE)) {
    return (val == EEPROM_VALUE_TRUE) ? true : false;
  } else {
    EEPROM.update(addr, (default_value ? EEPROM_VALUE_TRUE : EEPROM_VALUE_FALSE));
    return default_value;
  }
}

void eeprom_store_value(int addr, bool value)
{
  byte val = (value ? EEPROM_VALUE_TRUE : EEPROM_VALUE_FALSE);
  EEPROM.update(addr, val);
}

void eeprom_restore_values()
{
  is_turbo = eeprom_restore_value(EEPROM_TURBO_ADDRESS, is_turbo);
  profi_mode = eeprom_restore_value(EEPROM_MODE_ADDRESS, profi_mode);
  is_sw1 = eeprom_restore_value(EEPROM_SW1_ADDRESS, is_sw1);
  is_sw2 = eeprom_restore_value(EEPROM_SW2_ADDRESS, is_sw2);
  is_sw3 = eeprom_restore_value(EEPROM_SW3_ADDRESS, is_sw3);
  is_sw4 = eeprom_restore_value(EEPROM_SW4_ADDRESS, is_sw4);
  is_sw5 = eeprom_restore_value(EEPROM_SW5_ADDRESS, is_sw5);
  is_sw6 = eeprom_restore_value(EEPROM_SW6_ADDRESS, is_sw6);
  is_sw7 = eeprom_restore_value(EEPROM_SW7_ADDRESS, is_sw7);
  is_sw8 = eeprom_restore_value(EEPROM_SW8_ADDRESS, is_sw8);
  is_mouse_swap = eeprom_restore_value(EEPROM_MOUSE_SWAP_ADDRESS, is_mouse_swap);
  
  // apply restored values
  matrix[ZX_K_TURBO] = is_turbo;
  matrix[ZX_K_SW1] = is_sw1;
  matrix[ZX_K_SW2] = is_sw2;
  matrix[ZX_K_SW3] = is_sw3;
  matrix[ZX_K_SW4] = is_sw4;
  matrix[ZX_K_SW5] = is_sw5;
  matrix[ZX_K_SW6] = is_sw6;
  matrix[ZX_K_SW7] = is_sw7;
  matrix[ZX_K_SW8] = is_sw8;
  matrix[ZX_K_KBD_MODE] = profi_mode;
}

void eeprom_store_values()
{
  eeprom_store_value(EEPROM_TURBO_ADDRESS, is_turbo);
  eeprom_store_value(EEPROM_MODE_ADDRESS, profi_mode);
  eeprom_store_value(EEPROM_SW1_ADDRESS, is_sw1);
  eeprom_store_value(EEPROM_SW2_ADDRESS, is_sw2);
  eeprom_store_value(EEPROM_SW3_ADDRESS, is_sw3);
  eeprom_store_value(EEPROM_SW4_ADDRESS, is_sw4);
  eeprom_store_value(EEPROM_SW5_ADDRESS, is_sw5);
  eeprom_store_value(EEPROM_SW6_ADDRESS, is_sw6);
  eeprom_store_value(EEPROM_SW7_ADDRESS, is_sw7);
  eeprom_store_value(EEPROM_SW8_ADDRESS, is_sw8);
  eeprom_store_value(EEPROM_MOUSE_SWAP_ADDRESS, is_mouse_swap);
}

// initial setup
void setup()
{
  Serial.begin(115200);
  Serial.flush();
  rtc.begin();
  pinMode(PIN_JOY_RIGHT, OUTPUT);
  digitalWrite(PIN_JOY_RIGHT, LOW);
  SPI.begin();

  // set up fast ADC
  // Bit 7 - ADEN: ADC Enable
  // Bit 6 - ADSC: ADC Start Conversion
  // Bit 5 - ADATE: ADC Auto Trigger Enable
  // Bit 4 - ADIF: ADC Interrupt Flag
  // Bit 3 - ADIE: ADC Interrupt Enable
  // Bits 2:0 - ADPS[2:0]: ADC Prescaler Select Bits
  //ADCSRA = (ADCSRA & B11111000) | 4;

  pinMode(PIN_SS, OUTPUT);
  digitalWrite(PIN_SS, HIGH);

  pinMode(PIN_LED1, OUTPUT);
  digitalWrite(PIN_LED1, HIGH);

  pinMode(PIN_LED2, OUTPUT);
  digitalWrite(PIN_LED2, HIGH);

  pinMode(PIN_BTN1, INPUT_PULLUP);
  pinMode(PIN_BTN2, INPUT_PULLUP);

  // ps/2

  pinMode(PIN_KBD_CLK, INPUT_PULLUP);
  pinMode(PIN_KBD_DAT, INPUT_PULLUP);

  pinMode(PIN_MOUSE_CLK, INPUT_PULLUP);
  pinMode(PIN_MOUSE_DAT, INPUT_PULLUP);

  // joy
  pinMode(PIN_JOY_UP, INPUT_PULLUP);
  pinMode(PIN_JOY_DOWN, INPUT_PULLUP);
  pinMode(PIN_JOY_LEFT, INPUT_PULLUP);
//  pinMode(PIN_JOY_RIGHT, INPUT_PULLUP);
  pinMode(PIN_JOY_FIRE1, INPUT_PULLUP);
  pinMode(PIN_JOY_FIRE2, INPUT_PULLUP);

  // clear full matrix
  clear_matrix(ZX_MATRIX_FULL_SIZE);

  // restore saved modes from EEPROM
  eeprom_restore_values();

  Serial.println(F("ZX Keyboard / mouse / rtc controller v1.0"));

  Serial.println(F("Waiting for FPGA init request"));
  // waiting for init
  while (!init_done) {
    spi_send(CMD_NONE, 0x00);
  }

  Serial.print(F("Keyboard init..."));
  kbd.begin(PIN_KBD_DAT, PIN_KBD_CLK);
  Serial.println("done");

  mouse_tries = MOUSE_INIT_TRIES;

  Serial.print(F("Mouse init..."));
  init_mouse();
  Serial.println("done");

  Serial.print(F("RTC init..."));
  rtc_year = rtc.getYear();
  rtc_month = rtc.getMonth();
  rtc_day = rtc.getDay();
  rtc_week = rtc.getWeek();

  rtc_hours = rtc.getHours();
  rtc_minutes = rtc.getMinutes();
  rtc_seconds = rtc.getSeconds();

  // read is_bcd, is_24h
  uint8_t reg_b = EEPROM.read(EEPROM_RTC_OFFSET + 0xB);
  rtc_is_bcd = !bitRead(reg_b, 2);
  rtc_is_24h = bitRead(reg_b, 1);

  rtc_send_time();
  Serial.println(F("done"));  

  if (!rtc_init_done) {
    Serial.print(F("RTC send all registers..."));
    rtc_send_all();
    Serial.println(F("done"));  
  }

  Serial.println(F("Starting main loop"));
  digitalWrite(PIN_LED1, LOW);
}


// main loop
void loop()
{
  unsigned long n = millis();

  if (kbd.available()) {
    int c = kbd.read();
    blink_state = true;
    tl = n;
    if (!led1_overwrite) {
      digitalWrite(PIN_LED1, HIGH);
    }
    fill_kbd_matrix(c);
    Serial.print(F("Scancode:"));
    Serial.println(c, HEX);
  }

  // transmit kbd always
  transmit_keyboard_matrix();

  // read joystick
  // Due to conflict with the hardware SPI, we should stop the HW SPI and switch the joy_right as input before reading
  // WARNING: a 100-500 Ohm resistor is required on the PIN_JOY_RIGHT line
  SPI.end();
  pinMode(PIN_JOY_RIGHT, INPUT_PULLUP);  
  joy[ZX_JOY_UP] = digitalRead(PIN_JOY_UP) == LOW;
  joy[ZX_JOY_DOWN] = digitalRead(PIN_JOY_DOWN) == LOW;
  joy[ZX_JOY_LEFT] = digitalRead(PIN_JOY_LEFT) == LOW;
  joy[ZX_JOY_RIGHT] = digitalRead(PIN_JOY_RIGHT) == LOW;
  joy[ZX_JOY_FIRE] = digitalRead(PIN_JOY_FIRE1) == LOW;
  joy[ZX_JOY_FIRE2] = digitalRead(PIN_JOY_FIRE2) == LOW;
  pinMode(PIN_JOY_RIGHT, OUTPUT);
  digitalWrite(PIN_JOY_RIGHT, LOW);
  SPI.begin();

  if (joy[0] != last_joy[0] || joy[1] != last_joy[1] || joy[2] != last_joy[2] || joy[3] != last_joy[3] || joy[4] != last_joy[4] || joy[5] != last_joy[5]) {
    last_joy[0] = joy[0];
    last_joy[1] = joy[1];
    last_joy[2] = joy[2];
    last_joy[3] = joy[3];
    last_joy[4] = joy[4];
    last_joy[5] = joy[5];
    Serial.print(F("Joystik:"));
    Serial.print(F(" U:")); Serial.print(joy[ZX_JOY_UP]);
    Serial.print(F(" D:")); Serial.print(joy[ZX_JOY_DOWN]);
    Serial.print(F(" L:")); Serial.print(joy[ZX_JOY_LEFT]);
    Serial.print(F(" R:")); Serial.print(joy[ZX_JOY_RIGHT]);
    Serial.print(F(" F:")); Serial.print(joy[ZX_JOY_FIRE]);
    Serial.print(F(" F2:")); Serial.println(joy[ZX_JOY_FIRE2]);
  }

  // transmit joy matrix
  transmit_joy_data();

  // react on hardware buttons every 100ms
#if USE_HW_BUTTONS
  if (n - tb >= 100) {
    if (analogRead(PIN_BTN1) < 3 && (n - tb1 >= 500) ) {
       tb1 = n;
      digitalWrite(PIN_LED2, HIGH);
      Serial.print(F("BTN1: Full reset..."));
      do_full_reset();
      Serial.println(F("done"));
      digitalWrite(PIN_LED2, LOW);      
    }

    if (analogRead(PIN_BTN2) < 3 && (n - tb2 >= 500) ) {
      tb2 = n;
      digitalWrite(PIN_LED1, HIGH);
      Serial.print(F("BTN2: Reset..."));
      do_reset();
      Serial.println(F("done"));
      digitalWrite(PIN_LED1, LOW);
    }
    tb = n;
  }
#endif

  // read time from rtc
  if (n - tr >= 500) {

    if (!rtc.isRunning()) {
      Serial.println(F("RTC is not running. Staring it..."));
      rtc.startClock();
    }

    rtc_year = rtc.getYear();
    rtc_month = rtc.getMonth();
    rtc_day = rtc.getDay();
    rtc_week = rtc.getWeek();

    rtc_hours = rtc.getHours();
    rtc_minutes = rtc.getMinutes();
    rtc_seconds = rtc.getSeconds();

    rtc_send_time();

    tr = n;
  }

  // try to re-init mouse every 1s if not present, up to N tries
  if (mouse_tries > 0 && !mouse_present && n - tm > 1000) {
    mouse_tries--;
    Serial.print(F("Mouse not present. Trying to init mouse: ")); Serial.println(mouse_tries);
    init_mouse();
    Serial.print(F("Mouse present: ")); Serial.println(mouse_present);
    tm = n;
  }

  // polling for mouse data
  #if MOUSE_POLL_TYPE == 1
  if (mouse_present && n - t > MOUSE_POLL_INTERVAL) {

    MouseData m = mouse.readData();

    mouse_new_packet = !mouse_new_packet;
    mouse_x = m.position.x;
    mouse_y = m.position.y;
    mouse_z = m.wheel;

    ms_btn1 = bitRead(m.status, 0);
    ms_btn2 = bitRead(m.status, 1);
    ms_btn3 = bitRead(m.status, 2);
    bitWrite(mouse_z, 4, is_mouse_swap ? ms_btn2 : ms_btn1); // left
    bitWrite(mouse_z, 5, is_mouse_swap ? ms_btn1 : ms_btn2); // right
    bitWrite(mouse_z, 6, ms_btn3); // middle
    bitWrite(mouse_z, 7, mouse_new_packet);

    transmit_mouse_data();

    t = n;
  }
  #else
  // mouse stream report read
  if (mouse.reportAvailable() > 0 ) {
    MouseData m = mouse.readReport();

    //if ((bitRead(m.status, 3) == 1) and (bitRead(m.status, 6) == 0) and (bitRead(m.status,7)== 0)) {
      mouse_new_packet = !mouse_new_packet;
      mouse_x = m.position.x;
      mouse_y = m.position.y;
      mouse_z = m.wheel;
  
      ms_btn1 = bitRead(m.status, 0);
      ms_btn2 = bitRead(m.status, 1);
      ms_btn3 = bitRead(m.status, 2);
      bitWrite(mouse_z, 4, is_mouse_swap ? ms_btn2 : ms_btn1); // left
      bitWrite(mouse_z, 5, is_mouse_swap ? ms_btn1 : ms_btn2); // right
      bitWrite(mouse_z, 6, ms_btn3); // middle
      bitWrite(mouse_z, 7, mouse_new_packet);
  
      transmit_mouse_data();    
    //}
  }

  #endif

  // swap mouse buttons
  if (mouse_present && n - ts > MOUSE_SWAP_INTERVAL) {
    if ((is_menu || (is_ctrl && is_alt)) && ms_btn1) {
      is_mouse_swap = !is_mouse_swap;
      eeprom_store_value(EEPROM_MOUSE_SWAP_ADDRESS, is_mouse_swap);
      digitalWrite(PIN_LED1, HIGH);
      delay(100);
      digitalWrite(PIN_LED1, LOW);
      delay(100);
      digitalWrite(PIN_LED1, HIGH);
      delay(100);
      digitalWrite(PIN_LED1, LOW);      
    }
    ts = n;
  }

  // control led1
  if (led1_overwrite) {
    if (led1_state == 1) {
      digitalWrite(PIN_LED1, HIGH);
    }
    if (n - tl1 >= 100) {
      tl1 = n;
      if (led1_state == false) {
        digitalWrite(PIN_LED1, LOW);
      }
    }
  }

  // control led2
  if (led2_overwrite) {
    if (led2_state == 1) {
      digitalWrite(PIN_LED2, HIGH);
    }
    if (n - tl2 >= 100) {
      tl2 = n;
      if (led2_state == false) {
        digitalWrite(PIN_LED2, LOW);
      }
    }
  }

}
