andykarpov/karabas-pro/firmware/src/fpga/profi/rtl/uart/zifi.vhd

--------------------------------------------------------------------------------
-- ZiFi module (API v1)
-- https://github.com/HackerVBI/ZiFi/blob/master/_esp/upd1/README!!__eRS232.txt
--
-- @author Andy Karpov <andy.karpov@gmail.com>
-- Ukraine, 2023
--------------------------------------------------------------------------------
library IEEE; 
use IEEE.std_logic_1164.all; 
use IEEE.std_logic_unsigned.all;
use IEEE.numeric_std.all; 

entity zifi is
port(
    CLK         : in std_logic;
    RESET       : in std_logic;
	 DS80        : in std_logic;

    A           : in std_logic_vector(15 downto 0);
    DI          : in std_logic_vector(7 downto 0);
    DO          : out std_logic_vector(7 downto 0);
    IORQ_N      : in std_logic;
    RD_N        : in std_logic;
    WR_N        : in std_logic;

    ZIFI_OE_N   : out std_logic;
	 
	 ENABLED     : out std_logic;
	 ZF_UART2	 : out std_logic;
	 
    UART_RX     : in std_logic;
    UART_TX     : out std_logic;
    UART_CTS    : out std_logic        
);
end zifi;

architecture rtl of zifi is

component uart 
port ( 
    clk_bus     : in std_logic;
	 ds80        : in std_logic;
    txdata      : in std_logic_vector(7 downto 0);
    txbegin     : in std_logic;
    txbusy      : out std_logic;
    rxdata      : out std_logic_vector(7 downto 0);
    rxrecv      : out std_logic;
    data_read   : in std_logic;
    rx          : in std_logic;
    tx          : out std_logic;
    rts         : out std_logic);
end component;

constant zifi_command_port  : std_logic_vector(15 downto 0) := x"C7EF"; -- 51183
constant zifi_error_port    : std_logic_vector(15 downto 0) := x"C7EF"; -- 51183
constant zifi_data_port     : std_logic_vector(15 downto 0) := x"BFEF"; -- 49135
constant zifi_in_fifo_port  : std_logic_vector(15 downto 0) := x"C0EF"; -- 49391
constant zifi_out_fifo_port : std_logic_vector(15 downto 0) := x"C1EF"; -- 49647
constant zifi_fifo_size     : std_logic_vector(7 downto 0) := x"FF";

signal command_reg          : std_logic_vector(7 downto 0);
signal err_reg              : std_logic_vector(7 downto 0);
signal di_reg               : std_logic_vector(7 downto 0);
signal do_reg               : std_logic_vector(7 downto 0);
signal api_enabled          : std_logic := '0';
signal api_sw_uart2			 : std_logic := '0';

signal fifo_tx_di           : std_logic_vector(7 downto 0);
signal fifo_tx_do           : std_logic_vector(7 downto 0);
signal fifo_tx_rd_req       : std_logic := '0';
signal fifo_tx_wr_req       : std_logic := '0';
signal fifo_tx_clr_req      : std_logic := '0';
signal fifo_tx_used         : std_logic_vector(7 downto 0) := (others => '0');

signal fifo_rx_di          : std_logic_vector(7 downto 0);
signal fifo_rx_do          : std_logic_vector(7 downto 0);
signal fifo_rx_rd_req      : std_logic := '0';
signal fifo_rx_wr_req      : std_logic := '0';
signal fifo_rx_clr_req     : std_logic := '0';
signal fifo_rx_used        : std_logic_vector(11 downto 0) := (others => '0');

signal fifo_rx_free        : std_logic_vector(7 downto 0) := (others => '1');
signal fifo_tx_free         : std_logic_vector(7 downto 0) := (others => '1');

signal tx_begin_req         : std_logic := '0';
signal txbusy               : std_logic := '0';
signal data_received        : std_logic;
signal data_read            : std_logic;

signal wr_allow : std_logic := '1';
signal rd_allow : std_logic := '1';
signal new_command : std_logic := '0';

type txmachine IS (idle, pull_tx_fifo, end_pull_tx_fifo, req_uart_tx, end_req_uart_tx);
type rxmachine IS (idle, push_rx_fifo, end_push_rx_fifo, ack_uart_read);

signal txstate : txmachine := idle; 
signal rxstate : rxmachine := idle;

begin

FIFO_IN: entity work.fifo
port map(
    clock => CLK,
    data  => fifo_tx_di,
    rdreq => fifo_tx_rd_req,
    wrreq => fifo_tx_wr_req,
    sclr  => fifo_tx_clr_req,
    q     => fifo_tx_do,
    usedw => fifo_tx_used
);

FIFO_OUT: entity work.fifo2
port map(
    clock => CLK,
    data  => fifo_rx_di,
    rdreq => fifo_rx_rd_req,
    wrreq => fifo_rx_wr_req,
    sclr  => fifo_rx_clr_req,
    q     => fifo_rx_do,
    usedw => fifo_rx_used
);

UART_RXTX: uart
port map (
    clk_bus   => CLK,
	 ds80      => DS80,
    txdata    => fifo_tx_do,
    txbegin   => tx_begin_req,
    txbusy    => txbusy,
    rxdata    => fifo_rx_di,
    rxrecv    => data_received,
    data_read => data_read,
    rx        => UART_RX,
    tx        => UART_TX,
    rts       => UART_CTS    
);

fifo_tx_di <= di_reg;
do_reg <= fifo_rx_do;

-- todo: подтверждение чтения полученного байта
-- data_read <= '1' when fifo_rx_used /= zifi_fifo_size else '0';

process (RESET, CLK)
begin
	 if RESET = '1' then 
			fifo_tx_rd_req <= '0';
			tx_begin_req <= '0';
			fifo_rx_wr_req <= '0';
			data_read <= '0';
			txstate <= idle;
			rxstate <= idle;
			
    elsif rising_edge(CLK) then

		  -- fifo tx -> uart tx 
		  case txstate is
	
			when idle => 
				-- if tx fifo is not empty and transmitter is not busy
				if (fifo_tx_used /= "00000000" and txbusy = '0') then 
					txstate <= pull_tx_fifo;
				end if;

			-- request to read byte from fifo
			when pull_tx_fifo =>  
				fifo_tx_rd_req <= '1';
				txstate <= end_pull_tx_fifo;

			-- end request to read byte from fifo
			when end_pull_tx_fifo => 
				fifo_tx_rd_req <= '0';
				txstate <= req_uart_tx;

			-- begin uart tx request
			when req_uart_tx => 
				tx_begin_req <= '1';
				txstate <= end_req_uart_tx;

		   -- end uart tx request
			when end_req_uart_tx => 
				tx_begin_req <= '0';
				txstate <= idle;
				
			when others => null;
		  end case;

        -- uart rx -> fifo rx
		  case rxstate is

			when idle => 
				data_read <= '0';
				-- if data byte received by uart receiver and fifo allowed to be pushed into it
				if (data_received = '1' and fifo_rx_used /= "111111111111") then 
					rxstate <= push_rx_fifo;
				end if;

			-- push byte into rx fifo request
			when push_rx_fifo => 
				fifo_rx_wr_req <= '1';
				rxstate <= end_push_rx_fifo;
				data_read <= '1';
			-- push byte into rx fifo end request
			when end_push_rx_fifo => 
				fifo_rx_wr_req <= '0';
				rxstate <= ack_uart_read;

			-- confirm to uart receiver that byte was read successfully
			when ack_uart_read => 
				--data_read <= '1';
				rxstate <= idle;
			
			when others => null;
		  end case;
    end if;
end process;

process (CLK, RESET) 
begin
    if (RESET = '1') then
        command_reg <= (others => '0');
        di_reg <= (others => '0');
		  new_command <= '0';
		  wr_allow <= '1';
		  rd_allow <= '1';
		  fifo_tx_wr_req <= '0';
		  api_enabled <= '0';
		  api_sw_uart2 <= '0';
		  
    elsif (rising_edge(CLK)) then
        -- запись данных в порт данных инициирует fifo_tx  write request
        if IORQ_N = '0' and WR_N = '0' then 
            case (A) is
                when zifi_command_port => 
						if (wr_allow = '1' and new_command = '0') then 
							command_reg <= DI;
							wr_allow <= '0';
							new_command <= '1'; 
						end if;
                when zifi_data_port    => 
						if (fifo_tx_wr_req = '0' and wr_allow = '1') then
							wr_allow <= '0';
							di_reg <= DI; fifo_tx_wr_req <= '1';
						end if;
                when others => null;
            end case;
        end if;
		  if (WR_N = '1') then 
			wr_allow <= '1';
		  end if;
        if (fifo_tx_wr_req = '1') then 
            fifo_tx_wr_req <= '0';
        end if;

        -- чтение данных из порта данных инициирует fifo_rx read request
        if IORQ_N = '0' and RD_N = '0' and A = zifi_data_port then
				if (fifo_rx_rd_req = '0' and rd_allow = '1') then
					fifo_rx_rd_req <= '1';
					rd_allow <= '0';
				end if;
        end if;
        if (fifo_rx_rd_req = '1') then
            fifo_rx_rd_req <= '0';
        end if;
		  if (RD_N = '1') then 
				rd_allow <= '1';
		  end if;
		  
		  -- отработка команды
		  if new_command = '1' then
			  case (command_reg) is
					when "00000001" => fifo_rx_clr_req  <= '1'; err_reg <= (others => '0'); new_command <= '0';  -- clear rx fifo
					when "00000010" => fifo_tx_clr_req <= '1'; err_reg <= (others => '0'); new_command <= '0'; -- clear tx fifo
					when "00000011" => fifo_tx_clr_req  <= '1'; err_reg <= (others => '0'); fifo_rx_clr_req <= '1'; new_command <= '0'; -- clear both in/out fifo
					when "00000100" => api_sw_uart2 <= '0' ; fifo_tx_clr_req  <= '1'; err_reg <= (others => '0'); fifo_rx_clr_req <= '1'; new_command <= '0'; -- switch to uart1
				   when "00000101" => api_sw_uart2 <= '1' ; fifo_tx_clr_req  <= '1'; err_reg <= (others => '0'); fifo_rx_clr_req <= '1'; new_command <= '0'; -- switch to uart2	
					when "11110000" => api_enabled      <= '0'; err_reg <= (others => '0'); new_command <= '0'; -- api disabled
					when "11110001" => api_enabled      <= '1'; err_reg <= (others => '0'); new_command <= '0'; -- api transparent
					when "11111111" => -- get API version
											 if (api_enabled = '1') then 
												  err_reg <= "00000001"; 
											 else 
												  err_reg <= "11111111"; 
											 end if;
											 new_command <= '0';
					when others => err_reg <= "11111111"; new_command <= '0';
			  end case;
		  end if;
        if fifo_tx_clr_req = '1' then 
            fifo_tx_clr_req <= '0';
        end if;
        if fifo_rx_clr_req = '1' then
            fifo_rx_clr_req <= '0';
        end if;
    end if;
end process;

DO <= "11111111"  when IORQ_N = '0' and RD_N = '0' and A = zifi_in_fifo_port and fifo_rx_used > 255  else 
	fifo_rx_used(7 downto 0)  when IORQ_N = '0' and RD_N = '0' and A = zifi_in_fifo_port  else 
   fifo_tx_free when IORQ_N = '0' and RD_N = '0' and A = zifi_out_fifo_port else 
   err_reg       when IORQ_N = '0' and RD_N = '0' and A = zifi_error_port    else 
   do_reg        when IORQ_N = '0' and RD_N = '0' and A = zifi_data_port     else 
   "11111111";

fifo_tx_free <= std_logic_vector(unsigned(zifi_fifo_size) - unsigned(fifo_tx_used));
--fifo_rx_free <= std_logic_vector(unsigned(zifi_fifo_size) - unsigned(fifo_rx_used));
        
ZIFI_OE_N <= '0' when IORQ_N = '0' and RD_N = '0' and (A = zifi_in_fifo_port or A = zifi_out_fifo_port or A = zifi_error_port or A = zifi_data_port) else '1';

ENABLED <= api_enabled;
ZF_UART2 <= api_sw_uart2;

end rtl;
