andykarpov/karabas-pro/firmware/src/fpga/profi_plus3e/rtl/video/osd.vhd

library IEEE; 
use IEEE.std_logic_1164.all; 
use IEEE.numeric_std.ALL;
use IEEE.std_logic_unsigned.all;

entity osd is
	port (
		CLK		: in std_logic;
		CLK2 		: in std_logic;
		RGB_I 	: in std_logic_vector(8 downto 0);
		RGB_O 	: out std_logic_vector(8 downto 0);
		DS80		: in std_logic;
		HCNT_I	: in std_logic_vector(9 downto 0);
		VCNT_I	: in std_logic_vector(8 downto 0);
		BLINK 	: in std_logic;
		LOADED 	: in std_logic;
		
		-- sensors
		TURBO 			: in std_logic := '0';
		SCANDOUBLER_EN : in std_logic := '0';
		MODE60 			: in std_logic := '0';
		ROM_BANK 		: in std_logic_vector := "00";
		KB_MODE 			: in std_logic := '1';
		KB_WAIT 			: in std_logic := '0';
		SSG_MODE 		: in std_logic := '0';
		SSG_STEREO 		: in std_logic := '0';
		COVOX_EN 		: in std_logic := '0';
		TURBO_FDC		: in std_logic := '0';
		SSG_MONO 		: in std_logic := '0';
		FDC_SWAP 		: in std_logic := '0';
		JOY_TYPE 		: in std_logic := '0'
	);
end entity;

architecture rtl of osd is

	component rom_font
    port (
        address : in std_logic_vector(11 downto 0);
        clock   : in std_logic;
        q       : out std_logic_vector(7 downto 0)
    );
    end component;

	signal hcnt : std_logic_vector(9 downto 0);
	signal vcnt : std_logic_vector(8 downto 0);
	
	signal char_x: std_logic_vector(2 downto 0);
   signal char_y: std_logic_vector(3 downto 0);
	signal hpos : std_logic_vector(2 downto 0);
	signal char:   std_logic_vector(7 downto 0);
	
	signal rom_addr: std_logic_vector(11 downto 0);
	signal font_word: std_logic_vector(7 downto 0);
	signal vpos : std_logic_vector(1 downto 0) := "00";
	signal bit_addr: std_logic_vector(2 downto 0);
	signal pixel: std_logic;
		
	-- Define message addresses displayed
	constant message_turbo: 	integer 	:= 0;
	constant message_vga: 		integer 	:= 8;
	constant message_rgb: 		integer 	:= 16;
	constant message_on:	 		integer 	:= 24;
	constant message_off: 		integer  := 32;
	constant message_rombank: 	integer 	:= 40;
	constant message_rombank0:	integer 	:= 48;
	constant message_rombank1:	integer 	:= 56;
	constant message_rombank2:	integer 	:= 64;
	constant message_rombank3:	integer 	:= 72;
	constant message_50hz: 		integer 	:= 80;
	constant message_60hz: 		integer 	:= 88;
	constant message_keyboard: integer  := 96;
	constant message_profi:    integer 	:= 104;
	constant message_spectrum: integer 	:= 112;
	constant message_pause:    integer 	:= 120;
	constant message_empty: 	integer 	:= 128;
	constant message_ssgmode:  integer  := 136;
	constant message_ym_abc:	integer 	:= 144;
	constant message_ym_acb:	integer 	:= 152;
	constant message_ay_abc:	integer  := 160;
	constant message_ay_acb:	integer  := 168;
	constant message_ay_mono:  integer  := 176;
	constant message_ym_mono:  integer  := 184;
	constant message_covox:		integer 	:= 192;
	constant message_turbo_fdc:integer 	:= 200;
	constant message_karabas:  integer 	:= 208;
	constant message_fdc_swap: integer  := 216;
	constant message_joystick: integer  := 224;
	constant message_kempston: integer  := 232;
	constant message_sega:     integer  := 240;
	constant message_ver:      integer  := 248;

	signal message_addr : std_logic_vector(7 downto 0);

	-- displayable lines (addresses)
	signal line1 : std_logic_vector(7 downto 0) := std_logic_vector(to_unsigned(message_empty, 8));
	signal line2 : std_logic_vector(7 downto 0) := std_logic_vector(to_unsigned(message_empty, 8));
	
	signal last_turbo : std_logic := '0';
	signal last_scandoubler_en : std_logic := '0';
	signal last_mode60 : std_logic := '0';
	signal last_rom_bank : std_logic_vector(1 downto 0) := "00";
	signal last_kb_mode : std_logic := '1';
	signal last_kb_wait : std_logic := '0';
	signal last_ssg_mode : std_logic := '0';
	signal last_ssg_stereo : std_logic := '0';
	signal last_covox : std_logic := '0';
	signal kb_mode_init : std_logic := '0';
	signal last_turbo_fdc : std_logic := '0';
	signal last_ssg_mono : std_logic := '0';
	signal last_loaded : std_logic := '0';
	signal last_fdc_swap : std_logic := '0';
	signal last_joy_type: std_logic := '0';
	
	signal cnt : std_logic_vector(3 downto 0) := "1000";
	signal en : std_logic := '0';
	
	signal last_blink : std_logic := '0';
	
begin

	hcnt <= HCNT_I;
	vcnt <= VCNT_I;
	
	-- font rom
	U_FONT: rom_font
   port map (
		address => rom_addr,
      clock   => CLK2,
      q       => font_word
   );
	
	-- message rom
	U_MESSAGES: entity work.message_rom 
	port map (
		address 		=> message_addr,
		clock   		=> CLK2,
		q       		=> char
	);
	 
	char_x <= hcnt(3 downto 1) when DS80='1' else hcnt(2 downto 0);
   char_y <= vcnt(3 downto 0);
	rom_addr <= char & char_y;

	-- vertical bounds for line1 / line2
	vpos(0) <= '1' when (DS80='0' and MODE60 = '0' and vcnt >= 288 and vcnt < 304) or -- spectrum screen 50 Hz vpos 
							  (DS80='0' and MODE60 = '1' and vcnt >= 0 and vcnt < 16) or    -- spectrum screen 60 Hz vpos 
							  (DS80='1' and vcnt >= 16 and vcnt < 32) else '0';             -- profi 50/60 Hz vpos
	vpos(1) <= '1' when (DS80='0' and MODE60 = '0' and vcnt >= 304 and vcnt < 320) or -- spectrum screen 50 Hz vpos
	                    (DS80='0' and MODE60 = '1' and vcnt >= 16 and vcnt < 32) or   -- spectrum screen 60 Hz vpos 
	                    (DS80='1' and vcnt >= 32 and vcnt < 48) else '0';             -- profi 50/60 Hz vpos

	hpos <= hcnt(6 downto 4) when DS80 = '1' else hcnt(5 downto 3);
	
	-- message address
	message_addr <= line1 + hpos(2 downto 0) when vpos(0) = '1' and ((DS80 = '0' and hcnt < 64) or (DS80 = '1' and hcnt < 128)) else 
						 line2 + hpos(2 downto 0) when vpos(1) = '1' and ((DS80 = '0' and hcnt < 64) or (DS80 = '1' and hcnt < 128)) else 
						 std_logic_vector(to_unsigned(message_empty, 8));

	-- pixel 
	bit_addr <= char_x(2 downto 0);
   pixel <=  font_word(0) when bit_addr = "000" else 
				 font_word(7) when bit_addr = "001" else 
				 font_word(6) when bit_addr = "010" else 
				 font_word(5) when bit_addr = "011" else 
				 font_word(4) when bit_addr = "100" else 
				 font_word(3) when bit_addr = "101" else 
				 font_word(2) when bit_addr = "110" else 
				 font_word(1) when bit_addr = "111";

	process (CLK, CLK2, pixel, en)
	begin
		if rising_edge(CLK) then
			if (CLK2 = '1') then 
				if (en = '1' and pixel = '1') then 
					RGB_O <= "000111000";
				else 
					RGB_O <= RGB_I;
				end if;
			end if;
		end if;
	end process;
				 
	--RGB_O <= "000111000" when en = '1' and pixel = '1' else RGB_I;

	-- display messages for changed sensors
	process (CLK, BLINK, cnt, KB_WAIT, KB_MODE, TURBO, SCANDOUBLER_EN, MODE60, ROM_BANK, SSG_MODE, SSG_STEREO, last_ssg_mode, last_ssg_stereo, last_kb_wait, last_kb_mode, LOADED, last_loaded, last_turbo, last_scandoubler_en, last_mode60, last_rom_bank, COVOX_EN, last_covox, TURBO_FDC, last_turbo_fdc, SSG_MONO, last_ssg_mono, FDC_SWAP, last_fdc_swap)
	begin 
		if rising_edge(CLK) then 
		
			if CLK2 = '1' then
	
			-- init signal from AVR
			if (LOADED = '1' and last_loaded = '0') then
				last_loaded <= '1';
				last_kb_wait <= KB_WAIT;
				last_kb_mode <= KB_MODE;
				last_turbo <= TURBO;
				last_mode60 <= MODE60;
				last_scandoubler_en <= SCANDOUBLER_EN;
				last_rom_bank <= ROM_BANK;
				last_ssg_mode <= SSG_MODE;
				last_ssg_stereo <= SSG_STEREO;
				last_covox <= COVOX_EN;
				last_turbo_fdc <= TURBO_FDC;
				last_ssg_mono <= SSG_MONO;
				last_fdc_swap <= FDC_SWAP;
				last_joy_type <= JOY_TYPE;
				cnt <= "0000";
				line1 <= std_logic_vector(to_unsigned(message_karabas, 8));
				line2 <= std_logic_vector(to_unsigned(message_ver, 8));
				
			elsif (LOADED = '1') then
			
				-- wait switch
				if (KB_WAIT /= last_kb_wait) then
					last_kb_wait <= KB_WAIT;
					cnt <= "0000";
					line1 <= std_logic_vector(to_unsigned(message_pause, 8));
					if (kb_wait = '0') then 
						line2 <= std_logic_vector(to_unsigned(message_off, 8));
					else 
						line2 <= std_logic_vector(to_unsigned(message_on, 8));
					end if;
				end if;
				
				-- keyboard mode switch
				if (KB_MODE /= last_kb_mode) then
					last_kb_mode <= KB_MODE;
					cnt <= "0000";
					line1 <= std_logic_vector(to_unsigned(message_keyboard, 8));
					if (kb_mode = '0') then 
						line2 <= std_logic_vector(to_unsigned(message_spectrum, 8));
					else 
						line2 <= std_logic_vector(to_unsigned(message_profi, 8));
					end if;
				end if;
				
				-- turbo mode switch
				if (TURBO /= last_turbo) then
					last_turbo <= TURBO;
					cnt <= "0000";
					line1 <= std_logic_vector(to_unsigned(message_turbo, 8));
					if (turbo = '0') then 
						line2 <= std_logic_vector(to_unsigned(message_off, 8));
					else 
						line2 <= std_logic_vector(to_unsigned(message_on, 8));
					end if;
				end if;
				
				-- vga/rgb 50/60 hz switches
				if (MODE60 /= last_mode60 or scandoubler_en /= last_scandoubler_en) then 
					last_mode60 <= mode60;
					last_scandoubler_en <= scandoubler_en;
					cnt <= "0000";
					if (scandoubler_en = '1') then 
						line1 <= std_logic_vector(to_unsigned(message_vga, 8));
					else 
						line1 <= std_logic_vector(to_unsigned(message_rgb, 8));
					end if;
					if (mode60 = '1') then 
						line2 <= std_logic_vector(to_unsigned(message_60hz, 8));
					else 
						line2 <= std_logic_vector(to_unsigned(message_50hz, 8));
					end if;
				end if;
				
				-- rombank switch
				if (ROM_BANK /= last_rom_bank) then
					last_rom_bank <= ROM_BANK;
					cnt <= "0000";
					line1 <= std_logic_vector(to_unsigned(message_rombank, 8));
					if (ROM_BANK = "00") then 
						line2 <= std_logic_vector(to_unsigned(message_rombank0, 8));
					elsif (ROM_BANK = "01") then 
						line2 <= std_logic_vector(to_unsigned(message_rombank1, 8));
					elsif (ROM_BANK = "10") then 
						line2 <= std_logic_vector(to_unsigned(message_rombank2, 8));
					else 
						line2 <= std_logic_vector(to_unsigned(message_rombank3, 8));
					end if;
				end if;
				
				-- ssg mode switch
				if (SSG_MODE /= last_ssg_mode or SSG_STEREO /= last_ssg_stereo or SSG_MONO /= last_ssg_mono) then
					last_ssg_mode <= SSG_MODE;
					last_ssg_stereo <= SSG_STEREO;
					last_ssg_mono <= SSG_MONO;
					cnt <= "0000";
					line1 <= std_logic_vector(to_unsigned(message_ssgmode, 8));
					if (SSG_MODE = '0' and SSG_STEREO = '0' and SSG_MONO = '0') then 
						line2 <= std_logic_vector(to_unsigned(message_ym_acb, 8));
					elsif (SSG_MODE = '0' and SSG_STEREO = '1' and SSG_MONO = '0') then 
						line2 <= std_logic_vector(to_unsigned(message_ym_abc, 8));
					elsif (SSG_MODE = '1' and SSG_STEREO = '0' and SSG_MONO = '0') then 
						line2 <= std_logic_vector(to_unsigned(message_ay_acb, 8));
					elsif (SSG_MODE = '1' and SSG_STEREO = '1' and SSG_MONO = '0') then 
						line2 <= std_logic_vector(to_unsigned(message_ay_abc, 8));
					elsif (SSG_MODE = '0' and SSG_MONO = '1') then 
						line2 <= std_logic_vector(to_unsigned(message_ym_mono, 8));
					else 
						line2 <= std_logic_vector(to_unsigned(message_ay_mono, 8));
					end if;
				end if;
				
				-- turbo fdc mode switch
				if (TURBO_FDC /= last_turbo_fdc) then
					last_turbo_fdc <= TURBO_FDC;
					cnt <= "0000";
					line1 <= std_logic_vector(to_unsigned(message_turbo_fdc, 8));
					if (turbo_fdc = '0') then 
						line2 <= std_logic_vector(to_unsigned(message_off, 8));
					else 
						line2 <= std_logic_vector(to_unsigned(message_on, 8));
					end if;
				end if;
				
				-- covox mode switch
				if (COVOX_EN /= last_covox) then
					last_covox <= COVOX_EN;
					cnt <= "0000";
					line1 <= std_logic_vector(to_unsigned(message_covox, 8));
					if (covox_en = '0') then 
						line2 <= std_logic_vector(to_unsigned(message_off, 8));
					else 
						line2 <= std_logic_vector(to_unsigned(message_on, 8));
					end if;
				end if;
				
				-- fdc swap switch
				if (FDC_SWAP /= last_fdc_swap) then
					last_fdc_swap <= FDC_SWAP;
					cnt <= "0000";
					line1 <= std_logic_vector(to_unsigned(message_fdc_swap, 8));
					if (FDC_SWAP = '0') then 
						line2 <= std_logic_vector(to_unsigned(message_off, 8));
					else 
						line2 <= std_logic_vector(to_unsigned(message_on, 8));
					end if;
				end if;
				
				-- joy type
				if (JOY_TYPE /= last_joy_type) then
					last_joy_type <= JOY_TYPE;
					cnt <= "0000";
					line1 <= std_logic_vector(to_unsigned(message_joystick, 8));
					if (JOY_TYPE = '0') then 
						line2 <= std_logic_vector(to_unsigned(message_kempston, 8));
					else 
						line2 <= std_logic_vector(to_unsigned(message_sega, 8));
					end if;
				end if;
				
			end if;

			-- enable counter
			last_blink <= BLINK;
			if (BLINK = '1' and last_blink = '0' and cnt /= "1000") then 
				cnt <= cnt + 1;
			end if;
			
			end if;
			
		end if;
	end process;
	
	en <= '1' when cnt /= "1000" else '0';

end architecture;
