andykarpov/karabas-pro/firmware/src/fpga/profi/rtl/sound/turbosound/ym2149.sv

//
// Copyright (c) MikeJ - Jan 2005
// Copyright (c) 2016-2018 Sorgelig
//
// All rights reserved
//
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
// Redistributions in synthesized form must reproduce the above copyright
// notice, this list of conditions and the following disclaimer in the
// documentation and/or other materials provided with the distribution.
//
// Neither the name of the author nor the names of other contributors may
// be used to endorse or promote products derived from this software without
// specific prior written permission.
//
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


// BDIR  BC  MODE
//   0   0   inactive
//   0   1   read value
//   1   0   write value
//   1   1   set address
//

module YM2149
(
	input        CLK,       // Global clock
	input        CE,        // PSG Clock enable
	input        RESET,     // Chip RESET (set all Registers to '0', active hi)
	input        BDIR,      // Bus Direction (0 - read , 1 - write)
	input        BC,        // Bus control
	input  [7:0] DI,        // Data In
	output [7:0] DO,        // Data Out
	output [7:0] CHANNEL_A, // PSG Output channel A
	output [7:0] CHANNEL_B, // PSG Output channel B
	output [7:0] CHANNEL_C, // PSG Output channel C

	input        SEL,
	input        MODE,
	
	output [5:0] ACTIVE,
	input        A8,

	input  [7:0] IOA_in,
	output [7:0] IOA_out,

	input  [7:0] IOB_in,
	output [7:0] IOB_out
);

assign ACTIVE  = ~ymreg[7][5:0];
assign IOA_out = ymreg[14];
assign IOB_out = ymreg[15];

reg [7:0] addr;
reg [7:0] ymreg[16];

// Write to PSG
reg env_reset;
reg old_BDIR;
always @(posedge CLK) begin
	if(RESET) begin
		ymreg     <= '{default:0};
		ymreg[7]  <= '1;
		addr      <= '0;
		env_reset <= 0;
	end else begin
		env_reset <= 0;
		old_BDIR <= BDIR;
		if(~old_BDIR & BDIR & A8) begin
			if(BC) addr <= DI;
			else if(!addr[7:4]) begin
				ymreg[addr[3:0]] <= DI;
				env_reset <= (addr == 13);
			end
		end
	end
end
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
