andykarpov/karabas-pro/(commit log)

2020-06-22 Karabas Pro PCB rev.A
    [karabas-pro-revA.kicad_pcb, karabas-pro-revA.sch]
2020-06-22 Added pullups
    [karabas-pro-revA.kicad_pcb, karabas-pro-revA.sch]
2020-07-20 fixed sound, video out
    [karabas_pro.vhd, tda1543.vhd, video.vhd]
2020-07-20 added forced scandoubler video mode switch - ds80
2020-07-24 Added rev.A documentation
    [karabas-pro-revA.kicad_pcb, karabas-pro-revA.sch]
2020-07-25 PCB rev.B
    [karabas-pro-revB.kicad_pcb, karabas-pro-revB.sch]
2020-07-25 Updated PS/2 footprint
    [karabas-pro-revB.kicad_pcb, karabas-pro-revB.sch]
2020-07-28 timing fixes, disabled palette
    [pentagon_video.vhd, video.vhd]
2020-07-29 fixed fusebits
2020-07-29 Updated code / bugfixes, added macroses
    [avr.ino]
2020-07-30 added missing joystick pullups. added hardware buttons
    [avr.ino]
2020-07-30 new build, missing files
    [karabas_pro.vhd]
2020-07-30 уменьшено количество регистров для IDE
2020-07-30 поправлены сигналы DS0,DS1, мелкие правки
2020-07-31 reverted to a working version
    [fdd_controller.vhd, ide_controller.vhd, karabas_pro_cpld.vhd]
2020-07-31 fixed mouse buttons
2020-07-31 removed hardware buttons
2020-08-01 Adopted pong game for karabas-pro board: added keyboard controls, sound, etc
2020-08-02 added rtc emulation and R/O mode from AVR, added profi covox, reverted vga_pal
    [bus_port.vhd, cpld_kbd.vhd, karabas_pro.vhd, profi_video.vhd, vga_pal.vhd]
2020-08-02 fixed covox and rtc/mouse conflicts
    [karabas_pro.vhd]
2020-08-02 refactored rtc: addded fifo, added 2-port ram to reduce registers, added spi transfer to the avr host
2020-08-05 fix "profi mode" timings, int position and length
    [karabas_pro.vhd, profi_video.vhd]
2020-08-06 fix profi screen geometry
    [pentagon_video.vhd, profi_video.vhd]
2020-08-13 PCB rev.C
    [karabas-pro-revC.kicad_pcb, karabas-pro-revC.sch]
2020-08-14 Added a new optional resistor on the VGA connector
    [karabas-pro-revC.kicad_pcb, karabas-pro-revC.sch]
2020-09-02 Fix floppy drives selection
    Fix floppy drives selection
    [fdd_controller.vhd]
2020-09-20 Added rev.C SW3 dip switch pin assignments
2020-09-20 Separated project files for revA(B) with tda1543/tda1543a and revC (dac selected by dip switches)
2020-09-21 Fixed palette, a new release for all pcb revisions
    [karabas_pro.vhd, video.vhd]
2020-09-28 Added 60Hz mode for Profi mode
    Added 60Hz mode for Profi mode (only testing)
2020-10-03 hw interrupt refactored as a separate module
2020-10-04 compiled version with serial mouse for all pcb revisions
2020-10-04 Added UART by ZX UNO standard
2020-10-06 New keyboard shortcuts for turbo / magic (Menu+F11, Menu+F12), added initial support to overwrite led states from FPGA side
    [avr.ino, cpld_kbd.vhd, karabas_pro.vhd]
2020-10-07 Added HDD/SD status via AVR LEDs
2020-10-07 updated release with leds
2020-10-07 Added 100ms delay for active leds
2020-10-08 Added soft switches (Menu+F1, Menu+F2) for pcb revA,B
2020-10-08 Fixed Menu based hotkeys
    [avr.ino]
2020-10-08 some video fix
    1. Added 60Hz for Profi mode
    2. Added CSYNC for TV mode
    3. Fixed 7th bit Port FE for Spectrum mode (GX0 = '1' for Spectrum mode)
    4. Try added Port FF, works, but test needed
    [karabas_pro.vhd, pentagon_video.vhd, profi_video.vhd, serial_mouse.vhd, vga_pal.vhd, video.vhd]
2020-10-09 Added 60Hz mode for Spectrum mode
2020-10-11 Прошивка AVR с поддержкой записи RTC с хоста
2020-10-11 New release with ZX UNO UART
2020-10-11 Added board revision feature via SPI flash rom cfg byte
2020-10-11 Added missing ZXUNO UART register
    [karabas_pro.vhd]
2020-10-12 Added board revision feature
2020-10-13 refactoring: board revision module
2020-10-13 Code cleanup. Switchable SAA1099 support
2020-10-13 Added AVR revision with HW buttons
2020-10-18 Replaced soundrive with profi covox, adjusted covox volume in the final mixed signal
    [compr.v, compressor.vhd, covox.vhd, karabas_pro.vhd]
2020-10-25 fix video
    The position of the Spectrum screen and the Profi screen is centered for TV mode 60Hz.
    [pentagon_video.vhd, profi_video.vhd]
2020-10-26 fixed position Spectrum and Profi screens in VGA mode 50/60HZ
    [vga_pal.vhd]
2020-10-26 Release with fixed 60Hz timings
2020-10-30 Образ ПЗУ с PQ-DOS
2020-10-30 Добавлены cof файлы для создания JIC с ПЗУ PQ-DOS
2020-10-30 Образы JIC с ПЗУ PQ-DOS
2020-11-03 fixed fdd, ide, rtc and serial IO decoders for PQ-DOS
    [bus_port.vhd, fdd_controller.vhd, hw_int.vhd, ide_controller.vhd, karabas_pro.vhd, karabas_pro_cpld.vhd, serial_mouse.vhd]
2020-11-04 Refactoring: псевдо-параллельный SPI флеш интерфейс, вынесен из loader'а с задумкой использовать отдельно, включая запись (непроверено)
2020-11-06 added ports SPI FLASH at speccy side
    added ports SPI FLASH at speccy side:
    87 - LB SPI FLASH addr PAGE /wr
    A7 - HB SPI FLASH addr PAGE /wr
    C7 - status REG r/w
    xxE7 - Data reg r/w
    where xx byte in PAGE
2020-11-06 temporarily removed the ds80 signal from the decoders of the spi-flash ports.
2020-11-06 Младшая часть адреса для записи и чтения флехи - теперь #67
2020-11-07 refactoring: добавлен функционал стирания блока флешки перед записью
2020-11-07 Добавлено стирание флехи, пепеписан автомат записи
2020-11-07 добавлена ссыль на pdf-ку m25p16
2020-11-09 Added power/wait indication on led2
2020-11-09 Добавлены Soft-переключатели для ревизий плат А,Б
2020-11-09 Soft switches available via Ctrl+Alt+FXX
2020-11-09 Fixed multiple keys with CS
    [avr.ino, config.h]
2020-11-09 Release with multiple CS keys fixed
    [avr.ino, config.h]
2020-11-10 Rev.C1 (hotfix revision: CF 3.3V fix, SD DI fix)
    [karabas-pro-revC1.kicad_pcb, karabas-pro-revC1.sch]
2020-11-10 updated CF drills
    [karabas-pro-revC1.kicad_pcb]
2020-11-10 Transmit soft switches on every transmission
2020-11-10 rev.D, initial revision
    [karabas-pro-revD.kicad_pcb, karabas-pro-revD.sch]
2020-11-11 make *jic for all board revisions
    update branch from master
    make *jic for all board revisions in releases
2020-11-11 Updated rev.C1: added CF card /REG pullup
    [karabas-pro-revC1.kicad_pcb, karabas-pro-revC1.sch]
2020-11-11 Updated rev.D: added CF /REG pullup
    [karabas-pro-revD.kicad_pcb, karabas-pro-revD.sch]
2020-11-12 Added ESP GPIO BUS
    [karabas-pro-revD.kicad_pcb, karabas-pro-revD.sch]
2020-11-12 Added ERRATA rev.C
    [karabas-pro-revD.kicad_pcb, karabas-pro-revD.sch]
2020-11-12 Дока по хотфиксам, v1
2020-11-12 Исходники BOM-файлов
    [karabas-pro-revA.xlsx, karabas-pro-revB.xlsx, karabas-pro-revC.xlsx, karabas-pro-revC1.xlsx]
2020-11-12 rev.D gerbers
2020-11-18 Изменен футпринт танталовых кондеров, заведена нога FDC_STEP на PIN_119
    [karabas-pro-revD.kicad_pcb, karabas-pro-revD.sch]
2020-11-19 Включены верхний-нижний бордюры для профи экрана
2020-11-25 Добавлен новый rom map в конф флешке: адреса выровнены к 64к блокам, начинаются с 0x100000, конф байт переехал на адрес 0x1F0000
2020-11-25 Новый mapping кнопок для переключения ромсетов - Menu+F1...F4 переключают ромсеты 0,1,2,3. Переключение видео-режимов переехало на Menu+F9, Menu+F10
2020-11-25 Добавлен сброс при переключении банков ПЗУ
2020-11-25 Rev.D updates
    [karabas-pro-revD.kicad_pcb, karabas-pro-revD.sch]
2020-11-26 Fixed OSD font style for DS80 mode
    [osd.vhd]
2020-11-26 Убран *.mif из gitignore, закоммичен vgafont.mif
2020-11-27 Fixed OSD for the 60 Hz pentagon screen
    [osd.vhd]
2020-11-28 Grounded mounting holes and vga connector
    [karabas-pro-revC1.kicad_pcb, karabas-pro-revC1.sch, karabas-pro-revD.kicad_pcb, karabas-pro-revD.sch]
2020-11-28 Updated gerbers for rev.C1,D - grounded mounting holes
2020-11-28 updated rev.D docs
    [karabas-pro-revD.xlsx]
2020-11-29 FlashTool v2.7 + ZC SPI @ 28 MHz
2020-11-29 Replaced 3d models
    [karabas-pro-revC1.kicad_pcb]
2020-11-29 updated 3d models
    [karabas-pro-revD.kicad_pcb]
2020-12-01 Added keyboard layout OSD sensors
2020-12-01 fixed "write" operation in turbo fdc mode
    [fdd_controller.vhd, karabas_pro_cpld.vhd]
2020-12-06 Added more ground vias
    [karabas-pro-revD.kicad_pcb]
2020-12-09 Fixed RTC start/stop conditions
    [avr.ino]
2020-12-10 removed revC1, revD docs
    [karabas-pro-revC1.xlsx, karabas-pro-revD.xlsx]
2020-12-10 removed revC1, revD gerbers
2020-12-10 Updated rev.D gerbers
    [karabas-pro-revD.kicad_pcb, karabas-pro-revD.sch]
2020-12-10 removed rev.C1 sources
    [karabas-pro-revC1.kicad_pcb, karabas-pro-revC1.sch]
2020-12-10 Updated IP components, refactored PLLs a bit to avoid jitter
    [karabas_pro.vhd]
2020-12-11 Revert "removed revC1, revD docs"
    This reverts commit f0b6a2a6cb6653fc0ab13decc5467bcc7f23aa69.
    [karabas-pro-revC1.xlsx, karabas-pro-revD.xlsx]
2020-12-11 Revert "removed revC1, revD gerbers"
    This reverts commit 77218a298f29722d9db6573df5339a0aeb40716a.
2020-12-11 Revert "removed rev.C1 sources"
    This reverts commit 970e388289176660a40964912a2767850a5ef300.
    [karabas-pro-revC1.kicad_pcb, karabas-pro-revC1.sch]
2020-12-11 renamed revD alpha1 materials
2020-12-11 Added rev.D alpha2 gerbers
2020-12-11 fixed revD alpha1 bom
    [karabas-pro-revD-alpha1.xlsx]
2020-12-15 Release with more soft switches, selectable SSG type and stereo mode (ABC, ACB), etc
2020-12-16 Added TURBO FDC switch
    Added TURBO FDC switch - Menu+F5
2020-12-19 Fixed order of the kempston joy buttons
    [avr.vhd]
2020-12-20 Remapped (swapped) joy buttons Right with Fire2
    [config.h]
2020-12-20 New avr build with remapped buttons
2020-12-21 Soft SPI
2020-12-21 AVR releases with soft spi
2020-12-27 Releases with mouse btn swap feature
    [avr.ino, config.h, karabas_pro.vhd]
2021-01-03 OSD for TV mode fixed.
    OSD for TV mode fixed.
    [osd.vhd]
2021-01-06 ide output signal sync fixed
    [ide_controller.vhd]
2021-01-09 Reduced mouse poll interval to avoid keyboard freezes
    [avr.ino, config.h]
2021-01-10 Board rev.D alpha 3
    [karabas-pro-revD.kicad_pcb, karabas-pro-revD.sch]
2021-01-10 fdd & ide fixes
    [fdd_controller.vhd, ide_controller.vhd]
2021-01-11 Reverted to HW SPI with some tricks to read the PIN_JOY_RIGHT :)
    [avr.ino, config.h]
2021-01-11 Fixed keyboard mode switch
    [avr.ino]
2021-01-11 Added Pause button
2021-01-11 AVR build with wait on Pause button
2021-01-11 increased the length of the RESET signal after changes romsets
    [board.vhd, ide_controller.vhd]
2021-01-12 some fixes ide & fdd
    [fdd_controller.vhd, ide_controller.vhd]
2021-01-12 Added resistors on CLK lines
    [karabas-pro-revD.kicad_pcb, karabas-pro-revD.sch]
2021-01-12 changed battery footprint
    [karabas-pro-revD.kicad_pcb, karabas-pro-revD.sch]
2021-01-13 Fixed R32 value to 33 Ohm
    [karabas-pro-revD.kicad_pcb, karabas-pro-revD.sch]
2021-01-14 Added firmare with ESP8266 bridge to flash ESP8266 module on board via uBus connector pins 141, 121
2021-01-15 RevD alpha2 materials
    [karabas-pro-revD-alpha2.xlsx]
2021-01-15 Fixed bom
    [karabas-pro-revD-alpha2.xlsx]
2021-01-18 some fixes of ide&hdd_new ver. of mainrom_fatall
    [bus_port.vhd, fdd_controller.vhd, ide_controller.vhd, karabas_pro.vhd, osd.vhd]
2021-01-19 Fixed write to IDE
    Fixed write to IDE.
    FPGA-CPLD clock now 28/24MHz, not 84MHz (too many bugs)
    [bus_port.vhd, fdd_controller.vhd, ide_controller.vhd, karabas_pro.vhd, osd.vhd]
2021-01-19 Added mono/stereo switch
2021-01-24 Added interactive BOM files
2021-01-25 Revert "Added mono/stereo switch"
    This reverts commit 4f8ff2ea99367545a92d6b7a449a8849cc0462f6.
    [avr.ino, avr.vhd, config.h, karabas_pro.vhd, osd.vhd]
2021-01-25 revD alpha3 materials
2021-01-28 some IDE fixes
    - CF 2Gb TRANSCEND 133x Red label now works.
    [fdd_controller.vhd, ide_controller.vhd, karabas_pro_cpld.vhd]
2021-01-30 Обновлен мануал
2021-01-30 Убрана ревизия под дип-переключатели
2021-01-31 уменьшено количество попыток проинитить мышу
2021-01-31 Reverted board.vhd
2021-02-05 Release 21020510
    Added SounDrive device ports.
2021-02-13 Новая дешифрация бита 5 порта клавиатуры
2021-02-13 Fixed keyboard in PQ-DOS
    [avr.vhd]
2021-02-14 Added Paypal Donate button
2021-02-17 Small fixes: RTS isRunning check/startClock only once at start, fixed build script
    [main.cpp]
2021-02-18 Keyboard freezes fix attempt
    [main.cpp]
2021-02-18 Added VBat diodes
    [karabas-pro-revD.kicad_pcb, karabas-pro-revD.sch]
2021-02-20 Fixed PrtSc scancode parsing
    [config.h, main.cpp]
2021-02-20 Переделан светодиод busy для CF
    [karabas-pro-revD.kicad_pcb, karabas-pro-revD.sch]
2021-02-22 Added a few timequest clock constraints, fixed a few incorrect clocks
    [karabas_pro.vhd, tda1543.vhd, uart.v, video.vhd, zxunouart.v]
2021-03-02 Swapped L/R audio channels
    [karabas_pro.vhd]
2021-03-03 Добавлен образ бут дискетки PQ-DOS
2021-03-04 some fix in drive A selection
    [fdd_controller.vhd]
2021-03-07 revD pcb cache
2021-03-08 Reverted bus_port to CLK_BUS clock
    [bus_port.vhd]
2021-03-08 Release with mono switch
2021-03-08 Файлы качаются, а я должен был спать уже
2021-03-09 Added ability to use a secondary ZXUNO UART on internal ports C8,C9
2021-03-09 Added Menu+Tab shortcut for soft_sw10
    [main.cpp]
2021-03-09 reverted 84/72 MHz clock for bus port
    [bus_port.vhd]
2021-03-09 Added FDC SWAP rom message
    [osd.vhd]
2021-03-10 fix losted soft_switch for TURBO_FDC
    [karabas_pro.vhd]
2021-03-12 Karabas PCB rev.D final
    [karabas-pro-revD.kicad_pcb, karabas-pro-revD.sch]
2021-03-17 fix length of INT signal in TURBO mode
    fix length of INT signal in TURBO mode for Spectrum and Profi screens
    [karabas_pro.vhd, pentagon_video.vhd, profi_video.vhd, video.vhd]
2021-03-18 fixed TURBO mode selector, added 008B, 018B and 028B Config Ports
    [karabas_pro.vhd, osd.vhd, pentagon_video.vhd, profi_video.vhd, video.vhd]
2021-04-01 Fixed AVR rev.D firmware (LEDs states)
    [main.cpp]
2021-04-01 Fixed Kempston Joystick Port
    [karabas_pro.vhd]
2021-04-03 AVR firmware with sega gamepad support, a new hotkey to switch joystick type, etc
2021-04-03 fixed joy_type signal bug
    [avr.vhd]
2021-04-03 Fixed led2 in kempston joy mode
    [main.cpp]
2021-04-04 Disabled interrupts while sega joy reading
2021-04-04 Reverted interrupts
2021-04-04 Fixed sending joy byte
    [main.cpp]
2021-04-04 Release 21040418
    Added support for the Sega Genesis 3-button gamepad. Some pcb fix needed for it! See "karabas-pro-hotfixes-v1.pdf"
2021-04-09 Инструкция для Kalantaj
2021-04-10 pcb rev.DS - draft
    [karabas-pro-revDS.kicad_pcb, karabas-pro-revDS.sch]
2021-04-10 Updated pcb rev.DS
    [karabas-pro-revDS.kicad_pcb, karabas-pro-revDS.sch]
2021-04-10 pcb rev.DS gerbers and docs
2021-04-10 Added a PCB changelog
2021-04-12 Revert "Removed T80aw, updated T80a"
    This reverts commit 449ae43db1f41d384592dc9c70ec6d10ce0d6ef4.
    [T80a.vhd, karabas_pro.vhd]
2021-04-13 updated revDS: added diode and transistor before buzzer
    [karabas-pro-revDS.kicad_pcb, karabas-pro-revDS.sch]
2021-04-13 OSH logo - mask
    [karabas-pro-revDS.kicad_pcb]
2021-04-14 Added missing R for buzzer
    [karabas-pro-revDS.kicad_pcb, karabas-pro-revDS.sch]
2021-04-15 Cpld timings fix1 (#50)
    * Added counters for IDE_CS* signals
    * cpld build
    * Latest timings fixes
    * latest fixes
    [ide_controller.vhd]
2021-04-19 Win button acts as Menu as well
2021-05-05 latest version
    [karabas-pro-revDS.kicad_pcb, karabas-pro-revDS.sch]
2021-05-06 Revert "latest version"
    This reverts commit fe14166d25968ab133076a7a9191b22261ce910e.
    [karabas-pro-revDS.kicad_pcb, karabas-pro-revDS.sch]
2021-05-06 updated 3d models for PJ320D
    [karabas-pro-revDS.kicad_pcb]
2021-05-07 Magic button (#52)
    * Added support for magic button
    * Build 21050801
2021-05-10 Multi target ep4ec6, ep4ce10, ep3c10 (#53)
    * Moved syn files to ep4ce6 subfolder
    * fixed abs path
    * fixed abs path
    * Project file for ep4ce10 target
    * new build dir structure
    * added ep4ce10 build dir
    * updated readme
    * Builds for multiple targets: ep4ce6, ep4ce10
    * removed outdated builds
    * ep3c10 target
    * Added ep3c10 build
    * Added ep3c10 target, added tape in, out, buzzer out
    * Extended CF footprint
    [karabas-pro-revDS.kicad_pcb]
2021-05-18 Fixed 7FFD port decoding
    [karabas_pro.vhd]
2021-05-18 revert /M1 signal to 7FFD, DFFD, FFFD decoders
    [karabas_pro.vhd]
2021-06-01 Added 3D models for enclosures
    [KarabasDS_FDD_Logo_case_top_v1.0.stl, KarabasDS_FDD_case_bottom_v1.0.stl, Karabas_case_FDD_Logo_top_v1.stl, Karabas_case_FDD_bottom_Support_v1.stl, Karabas_case_FDD_bottom_v1.stl, Karabas_case_FDD_top_v1.stl, Karabas_case_bottom_v1.2.stl, Karabas_case_top_v1.2.stl]
2021-06-01 Fixed SDC include path
    [karabas_pro_ep4ce6.qsf]
2021-06-05 Added tapeMod rev.A pcb for older revisions
    [karabas-pro-tapeMod_revA.kicad_pcb, karabas-pro-tapeMod_revA.sch]
2021-07-04 Fixed beeper
    [karabas-pro-revDS.kicad_pcb, karabas-pro-revDS.sch]
2021-07-04 Updated gerbers, schematics for revDS
    [karabas-pro-revDS.kicad_pcb, karabas-pro-revDS.sch]
2021-07-04 Updated gerbers
2021-07-04 Updated logo
    [karabas-pro-revDS.kicad_pcb]
2021-07-05 pcb rev.E
    [karabas-pro-revE.kicad_pcb, karabas-pro-revE.sch]
2021-07-05 Rev.E gerbers, docs, bom
    [karabas-pro-revE.kicad_pcb, karabas-pro-revE.sch]
2021-07-06 Updated schematics: added note about optional terminators
    [karabas-pro-revDS.sch, karabas-pro-revE.sch]
2021-08-03 OSD overlay (#56)
    * First try - PS2KeyAdvanced
    * removed ps2 key advanced
    * Added PS2KeyAdvanced
    * Refactored special keys
    * polishing
    * AVR firmware release based on PS2KeyAdvanced library
    * Swapped some keys
    * updated FPGA firmware detection
    * Increased keyboard RX/TX buffers
    * New AVR build with increased buffers
    * VC Code workspace file
    * OSD overlay avr library
    * OSD overlay rx support
    * OSD overlay top level signals
    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
    [avr.vhd, karabas_pro.vhd, karabas_pro_ep4ce6.qsf, main.cpp, osd.vhd, overlay.vhd]
2021-08-04 добавлена обработка входных команд для вывода билда
2021-08-04 Fixed joystick bit order for OSD
    [main.cpp]
2021-08-05 added RTC fix invalid time on every RTC setup call
    [main.cpp]
2021-08-06 Fixed OSD attribute loading
    [overlay.vhd]
2021-08-07 Refactoring (#59)
    * Moved keyboard routines into library
    * Fixed order of kbd start
    * Fixed OSD popup
    * more refactoring
    * wrapped code into ZXRTC and ZXOSD libraries
    * Added ZXMouse, ZXJoystick libs
    * Optimizations
    * New OSD font with Karabas logo symbols
    * Textual improvements
    * new logo
    * Logo output
    * Textual changes
    * Release with a new OSD font
    * AVR build
    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
    [config.h, main.cpp]
2021-08-07 Added thin frame
2021-08-23 2port vram (#60)
    * initial refactoring to use a dedicated vram
    * Replaced videoram by 2-port BRAM
    * turbo 14mhz
    * Added function to swithc Turbo 7-14-28-off
    * AVR build with switchable turbo
    * FPGA dev build
    * Added support for old sram vram with max turbo restrictions on the AVR side
    * Добавлены парметры сборки
    * AVR firmware 21081015
    * FPGA build 21081015
    * Fixed new turbo EEPROM store/restore
    * New AVR release with fixed turbo eeprom store/restore
    * AVR release: fixed kbd led
    * test
    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
    [avr.vhd, bus_port.vhd, config.h, karabas_pro.vhd, karabas_pro_ep4ce6.qsf]
2021-08-23 Fixed N_CE* for 6MB SRAM versions
    [memory.vhd]
2021-09-16 Added classic 48k screen mode (#64)
    * Added video mode signal / osd implementation
    * OSD menu and hotkey for screen mode
    * osd fixes
    * Changed optimization technique
    * removed unused code
    * AVR release 21091500
    * FPGA build 21091500
    * Added classic timings
    * FPGA build 21091501
    * Contended memory emulation
    * Refactored OSD menu
    * AVR build 21091515
    * Build 21091515
    * Zoomed 2x osd popup font
    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
    [avr.vhd, ay_uart.vhd, compr.v, compressor.vhd, config.h, karabas_pro.vhd]
2021-10-16 New palette 333 (#65)
    * добавлен 3й бит синего в палитре через 7й бит порта #FE
    * fpga release 21101612
2021-10-21 UART cleanup: removed extra clocks from module
2021-10-25 fixed "turbo off" bit
    [karabas_pro.vhd]
2021-10-25 убран сигнал SD_NDET из порта #77
2021-10-25 Убрано условие cpm=0 из выборки портов z-controller 57,77
2021-10-31 Fix im0 bus (#71)
    * Changed condition to access CPLD bus
    * Test Build 21103113
    [karabas_pro.vhd]
2021-11-04 Fixed decoding port #7ffd bits 6,7
    [karabas_pro.vhd]
2021-11-11 Updated rev.E gerbers: added an additional logo on top side
    [karabas-pro-revE.kicad_pcb]
2021-11-16 Updated rev.Ё
    [karabas-pro-revER.kicad_sch]
2021-11-16 Updated ER gerbers
2021-11-22 Updated pcb
2021-11-25 Xm hz (#72)
    * added wait signal logic
    * x3 stable turbo mode
    * reverted UART2 CTS on PIN_138
    * Build 21112221
    * Removed outdated files
    * Build 21112222
    * fixed "turbo mode" async off
    * Build 21112419
    [bus_port.vhd, karabas_pro.vhd, karabas_pro_ep4ce6.qsf, memory.vhd, vga_pal.vhd]
2021-12-01 added NMI button in Profi Mode
2021-12-26 Updated pcb revER to kicad 6.0 file format
    [karabas-pro-revER.kicad_sch]
2022-03-15 Added PCB rev.Ї
    [karabas-pro-revEU.kicad_sch]
2022-03-15 Rtc 256 bytes (#75)
    * Added bank send/receive cmd while xchanging with FPGA
    * Added bank send/receive cmd while handling rtc address
    * New AVR and FPGA build with 256 bytes EEPROM
    * Refactored AVR protocol from 2 to 3 byte sequence
    * Refactored fpga side for the new SPI protocol
    * New experimental build with new SPI protocol and support for 256 bytes eeprom
    * Updated pong to the new 3-byte SPI protocol
    * Adopted RK86 core with new AVR SPI protocol
    * New pong core build with new AVR SPI protocol
    * Updated RK86 build with new AVR SPI protocol support
2022-03-15 Readme українською
2022-03-17 rev.Ї gerbers
2022-05-23 Fixed font rendering bugs in 15kHz mode
    [overlay.vhd]
2022-06-23 Fixed CF activity indicator
    [karabas_pro.vhd]
2023-01-03 Документация разработчика v1.0
2023-04-19 Reverted OSD icons, reverted ROMain to the version with embedded Fatall
    [karabas_pro.vhd, overlay.vhd]
2023-04-19 Build v23041922 with fixed ram usage on revE boards
    [karabas_pro.vhd, overlay.vhd]
2023-04-29 Fixed Rev.E 6MB memory access via port 7ffd bits 6,7
    [karabas_pro.vhd, memory.vhd, pentagon_video.vhd, profi_video.vhd, video.vhd]
2023-04-29 Добавлена опция отключаемых иконок OSD
2023-06-28 Zifi (#81)
    * ZIFI WIP
    * new zifi state machine, fixed reset
    * Added 4kb rx fifo for zifi
    * Moon Rabbit ZiFi support
    * Added WGET support for ZiFi
    * Удаление версии netman под karabas-pro в пользу оригинального репозитария nihirash
    * Удаление версии uGophy под karabas-pro в пользу оригинального репозитария nihirash
    * Добавлен readme
    * Добавлены сборки netman и ugophy под ZiFi UART, обновлены readme
    * Build with ZiFi instead of UNO UART
    * uGophy for profi hires screen 512x240
    * Initial working version of the weather report
    * Add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
    [http.asm, karabas_pro.vhd]
2023-07-11 DivMMC (#86)
    * Added DivMMC menu item into OSD menu
    * Added signal divmmc_en from avr
    * avr firmware build with divmmc switch
    * Divmmc (#85)
    * Merge changes from local repo
    * divmmc -> divmmc_en
    * Fix mistake is_romDIVMMC and is_ramDIVMMC
    * Implementation of memory logic and DIVMMC dhanged
    divmmc on/off logic removed , temporary only B48 rompage can be used
    not tested
    * Working version, but with glitches
    rombanks can't be switched, divmmc always enabled, garbage on the screen when Divmmc read/write memory (?)
    * DIVMMC mapping hooks reworked, NMI DIVMMC implemented
    ZC and DIVMMC work without switching (tested), NMI work correctly
    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
    [avr.vhd, karabas_pro.vhd, loader.vhd, main.cpp, memory.vhd, overlay.vhd]
2023-07-13 quick fix Divmmc not start issue in classic videomode (#87)
    stopping CPU clk cause error on DIVMMC io or mem operations (and maybe affect io or mem operations with other hardware, i don't lookd deeper)
    [karabas_pro.vhd]
2023-08-31 Nemoide (#94)
    * Added NemoIDE menu item, rearranged main menu
    * Added nemoide_en flag to the avr module
    * AVR build 22072122
    * Nemoidefinal (#93)
    * toCPLD_NEMO_EBL signal added
    * SDIR commented
    * SDIR logic changed, new pin 2 name assigned in CLPD
    * Nemo HDD signals added to main module
    * Added signals bus_port module
    * Bus to CPLD signals added
    * change decoding of #FE and #FD ports when Nemo enabled
    * Reading from CPLD when nemo selected - implemented
    * nemo_ebl_n to CPLD
    * Blink led, OSD when nemo accessed
    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
2023-09-02 Инит мыши ждет успешного reset
2023-09-06 Turbo fix (#104)
    * fdd swap fix
    the first time I did swapping of fdd by inverting bit 0 of the FF port, but then I changed it to a more accurate disk number with two bits, who knows, maybe someone wants to implement more than two fdds on karabas pro
    * fix issues in turbo mode
    now turbo work correctly in divmmc, in pqdos - turbo disabled only when trdos active
    [bus_port.vhd, fdd_controller.vhd, karabas_pro.vhd]
2024-01-18 fdd fix
    fdd fixed in turbo mode 2x/4x
    fdd controller refactored
    WF/DE pin is NC now
    [fdd_controller.vhd, karabas_pro.vhd]
2024-05-23 added support MISTer SCART cable
2025-02-09 Возврат к старой цветовой схеме, небольшие фиксы в переводах
2025-02-09 Нижняя часть корпуса с круглыми отверстиями 1мм под светодиоды и без поддержек для слотов
    [KarabasDS_FDD_case_bottom_v1.N.stl, nosupport.scad]
2025-02-09 HW buttons refactoring
2025-02-09 Fixed HW buttons
2025-09-24 fix uart and zifi in turbo mode x2 x4 (#113)
    The UART code was taken and adapted from the latest Spectrum ZXUNO kernel. The behavior of rts(cts) was corrected so that it (and the RX state machine) remain inactive until the Z80 reads an incoming byte. A minor fix was made to the Zifi code to avoid duplicate incoming bytes caused by the new UART code. It is now more stable and can work with any Z80 clock signal.
    [uart.v, zifi.vhd, zxunouart.v]
2026-10-23 Refactor AVR firmware to bare-metal avr-gcc HAL and data-driven OSD
    - Migrate from Arduino framework to pure avr-libc / avr-gcc
    - Implement register-based HAL: GPIO, SPI master, TWI master, Timer0 tick, ADC, external interrupts
    - Replace SBWire with lightweight TWI driver for DS1307 RTC
    - Convert ZXOSD procedural menu logic to PROGMEM data-driven descriptor tables
    - Decouple OSD output from Arduino Print/Stream classes
    - Replace EEPROM.h with <avr/eeprom.h>
    - Reduce Flash footprint from 99.2% (32,512 bytes) to ~79.8% (26,162 bytes), freeing >6.4 KB
    - Rebuild all release binaries via build_avr.sh
    - Add docs/PROJECT_MEMORY.md architecture reference
2026-10-23 Refactor ZXKeyboard to PROGMEM LUT-based scancode translation
    - Implement two-level LUT architecture in ZXKeyboardMap.h
    - Replace 60+ procedural switch-cases with direct-indexed O(1) PROGMEM table
    - Add dedicated hotkey dispatcher table for Menu/Win/Ctrl+Alt modifier actions
    - Preserve 100% compatibility with Extended Mode typing macros (sendMacros)
    - Net reduction of 359 lines of procedural branching code
    - Reduce Flash footprint by another 2.3 KB (now 72.8%, down from original 99.2%)
    - Rebuild all 10 release variants via build_avr.sh
2026-10-23 Refactor AVR firmware to pure C and optimize libraries
    - Convert entire AVR firmware to pure C (gnu11), eliminating all C++ runtime overhead
    - Collapse double-layer driver wrappers:
    * Merge RTC (DS1307 + DateTime) and ZXRTC into unified rtc.c / rtc.h with fast I2C burst read
    * Merge SegaController and ZXJoystick into fast port-manipulated joystick.c / joystick.h
    * Merge PS2Mouse and ZXMouse into unified mouse.c / mouse.h
    * Replace 1,000-line PS2KeyAdvanced library with lightweight ps2_kbd.c / ps2_kbd.h
    * Convert ZXKeyboard into pure C keyboard.c / keyboard.h retaining LUT keyboard_map.h and sendMacros
    * Convert OSD and ZXOSD into pure C osd.c / zxosd.c with table-driven menus
    *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
2026-10-23 Refactor AVR firmware: clean up main.c, eliminate callbacks, streamline architecture
    - Replace Arduino setup()/loop() boilerplate with standard main(void) and structured lifecycle
    - Eliminate function pointer callbacks (s_on_kbd_cb, s_on_mouse_cb, s_on_time_cb, s_on_joy_cb)
    - Implement direct keyboard-to-OSD event dispatch (zxosd_on_key_event, zxosd_update_scancode)
    - Move joystick-to-key matrix mapping into keyboard_apply_joy()
    - Encapsulate OSD popup lifecycle and timers inside zxosd
    - Replace update_led wrapper with direct hal_led setters
    - Remove delay_us(1) cycle waster
    - Update release binaries
2026-10-23 Unify AVR firmware into universal build and fix OSD logo
    - Implement bulletproof PS/2 keyboard initialization with 25 ms TX watchdog timeout:
    * Protects against bus freeze when keyboards or passive USB adapters do not clock lines
    * Non-blocking periodic ECHO probing for hot-plugging and KVM switches
    * Unconditional send_cs for ZX Spectrum cursor arrow recognition
    - Move hardware variations (LED override, HW buttons) to EEPROM configuration:
    * EEPROM 0x12: LED override by FPGA (10 = enabled / default, 20 = disabled)
    * EEPROM 0x13: Hardware buttons Reset/Magic (10 = enabled / default, 20 = disabled)
    * Automatic self-initialization of blank EEPROMs on first boot
    - Generate default k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
2026-10-23 Add revision-specific EEPROM files and update flashing documentation
    - Generate karabas_pro_revA.eep (Rev. A/B without HW buttons), karabas_pro_revC.eep (Rev. C with HW buttons and LED override), and karabas_pro_revD.eep (Rev. D/E with HW buttons and local AVR LEDs)
    - Default karabas_pro.eep and virgin EEPROM fallback set to Rev. D+ defaults
    - Automatically distribute all revision EEPROM files to profi, profi_plus3e, pong, and rk86 release directories
    - Update README files across all targets with revision selection guide and avrdude flashing examples
2026-10-23 Fix OSD freeze after idle timeout
    - Remove illegal KEY_IGNORE (0xBB) byte transmission over the wire in ps2_kbd_echo() and ps2_kbd_set_lock()
    - Stop unsolicited ECHO probes when keyboard is already detected, preventing bus collision and controller crashes during OSD idle
    - Add resend retry limit (max 3) in decode_scancode() to prevent infinite resend loops
    - Bypass send_cs() 20ms delay when in OSD overlay
2026-10-24 Add GitHub Actions CI/CD workflows, PlatformIO build hooks, and pre-commit hook
    - Add .github/workflows/build-avr.yml: CI pipeline on push/PR, memory limit verification, release drift check, and step summary
    - Add .github/workflows/release.yml: Automated release packaging and publishing on tag push with bundle zip archive
    - Add PlatformIO extra_scripts (pre_build.py, post_build.py) to automatically generate revision-specific EEPROMs and sync releases on build
    - Add .githooks/pre-commit and scripts/install-hooks.sh to automatically rebuild and stage release binaries on commit
    - Simplify firmware/src/build_avr.sh to use PlatformIO hooks
    - Add CI build status badge to README.md
