andykarpov/karabas-pro/(notices)

Notices in the files:
firmware/src/fpga/profi_plus3e/rtl/sound/turbosound/saa1099.sv:
under the terms of the GNU General Public License as published by the Free
firmware/src/fpga/profi/rtl/uart/uart.v:
ZXUNO Spectrum core is free software: you can redistribute it and/or modify
it under the terms of the GNU General Public License as published by
the Free Software Foundation, either version 3 of the License, or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
pcb/revC/karabas-pro-revC.kicad_pcb:
© 2020 andykarpov
